squarewavedot/ledcubeelectronics/kiss-battery/v0.2/img-exports/battery-connectors.png

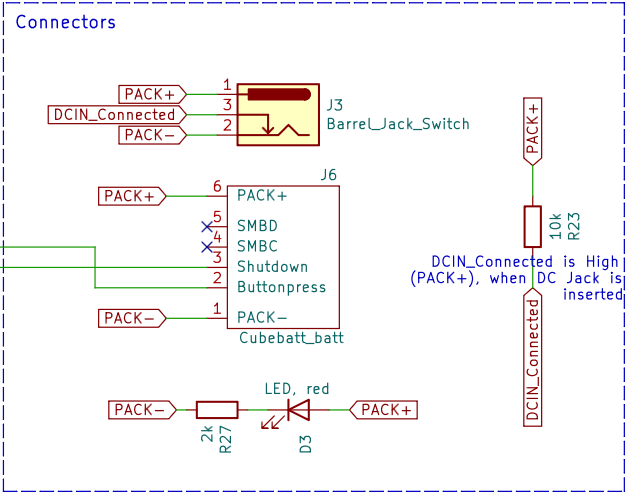
kiss-battery/v0.2/img-exports/battery-connectors.png
