squarewavedot/ledcubeelectronics/kiss-battery/v0.2/img-exports/bms.png

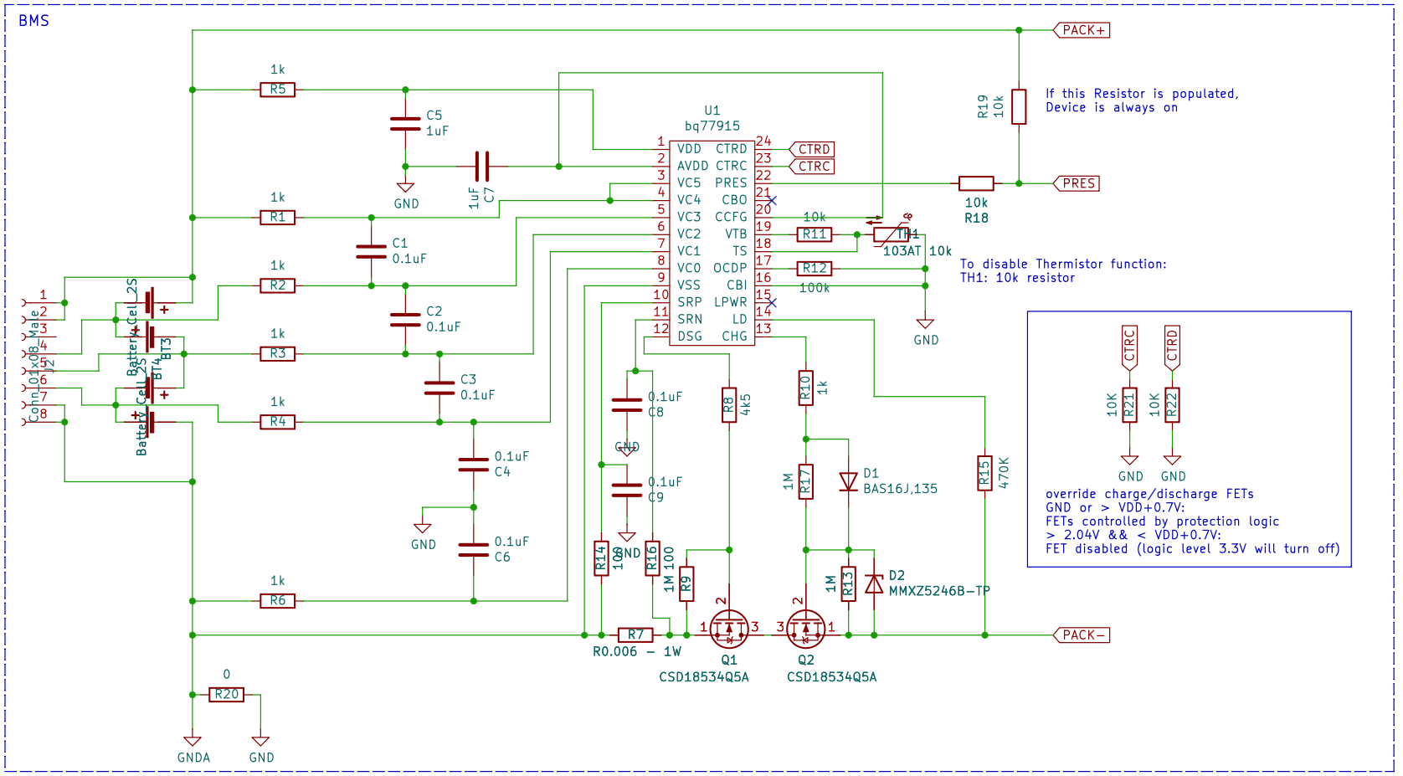
kiss-battery/v0.2/img-exports/bms.png
