squarewavedot/ledcubeelectronics/kiss-battery/v0.2/img-exports/push-button.png

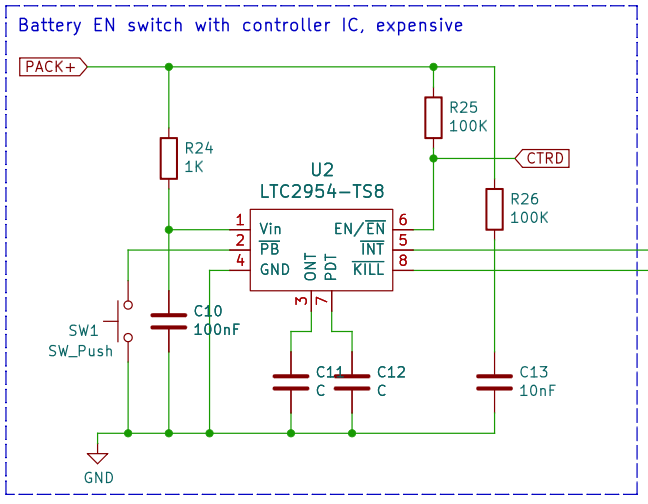
kiss-battery/v0.2/img-exports/push-button.png
