squarewavedot/ledcubeelectronics/kiss-battery/v0.2/bottom/kiss-battery_bottom.pdf

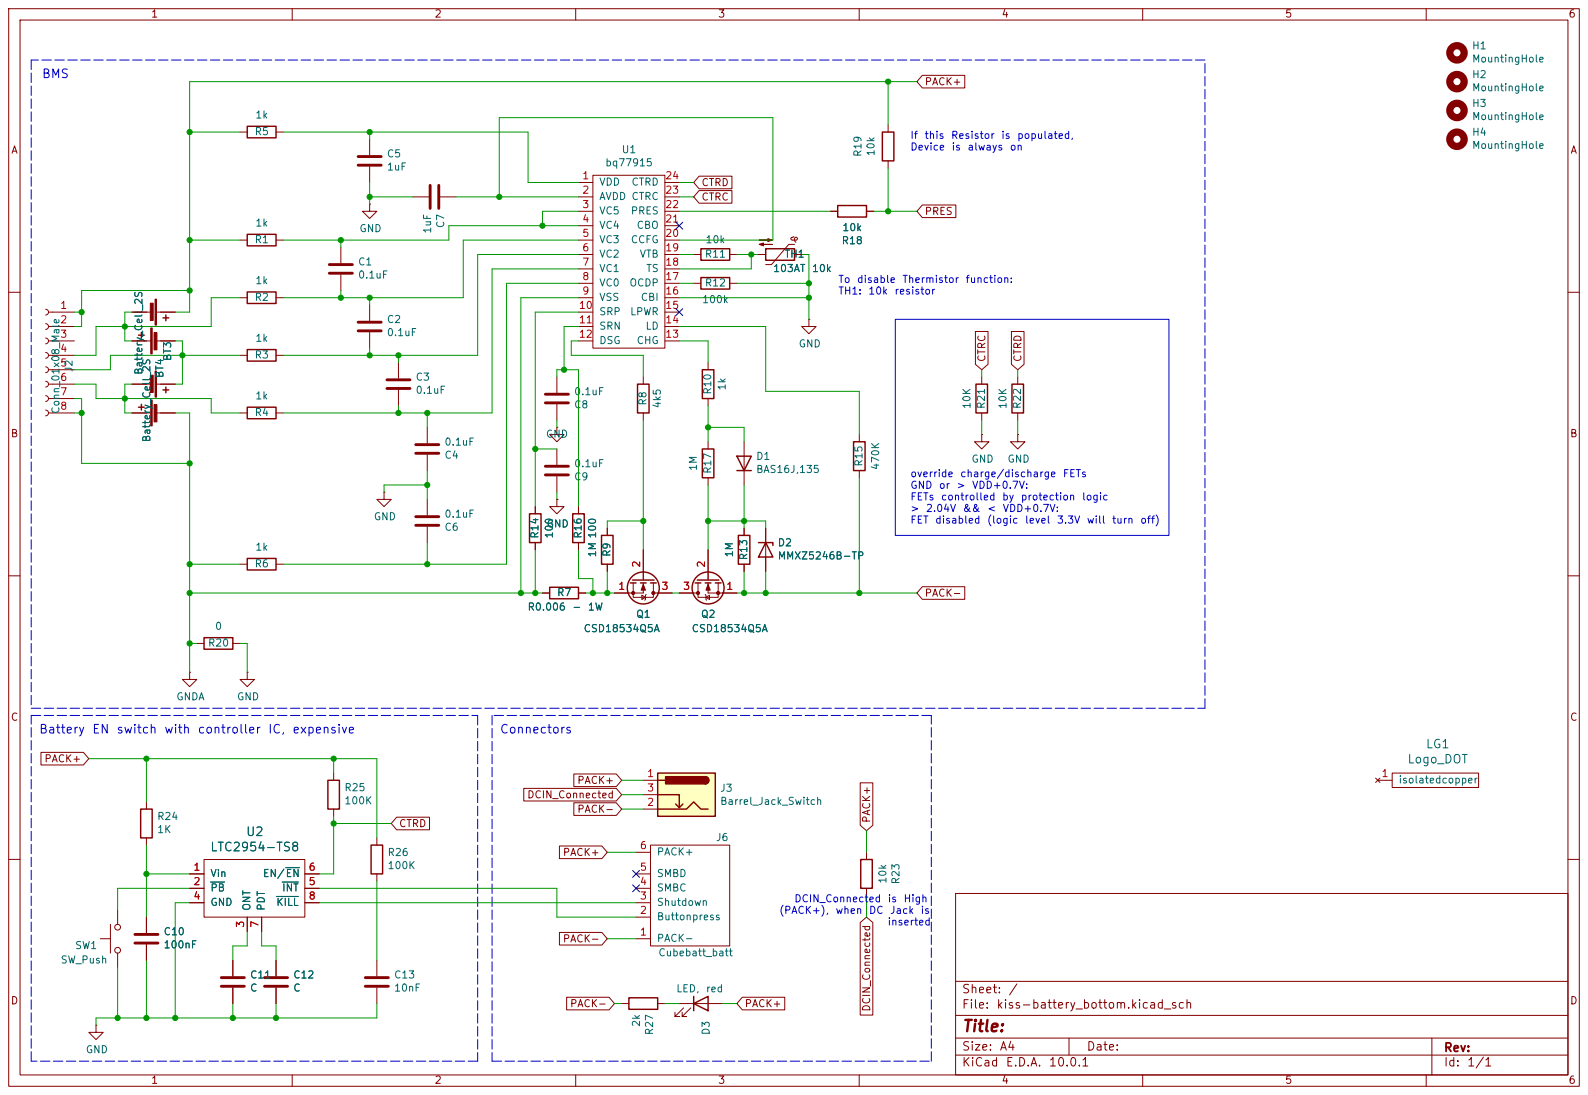
[picture p4: page 1]

If this Resistor is populated, Device is always on

To disable Thermistor function: TH1: 10k resistor

override charge/discharge FETs GND or > VDD+0.7V: FETs controlled by protection logic > 2.04V && < VDD+0.7V: FET disabled (logic level 3.3V will turn off)

Battery EN switch with controller IC, expensive

Size: A4 | Rev:
KiCad E.D.A. 10.0.1 | Id: 1/1
