squarewavedot/ledcubeelectronics/kiss-masterboard/masterboard_v0.2/kiss-masterboard.kicad_pcb

## KiCad design kiss-masterboard/masterboard_v0.2/kiss-masterboard.kicad_pcb (2026-04-28)

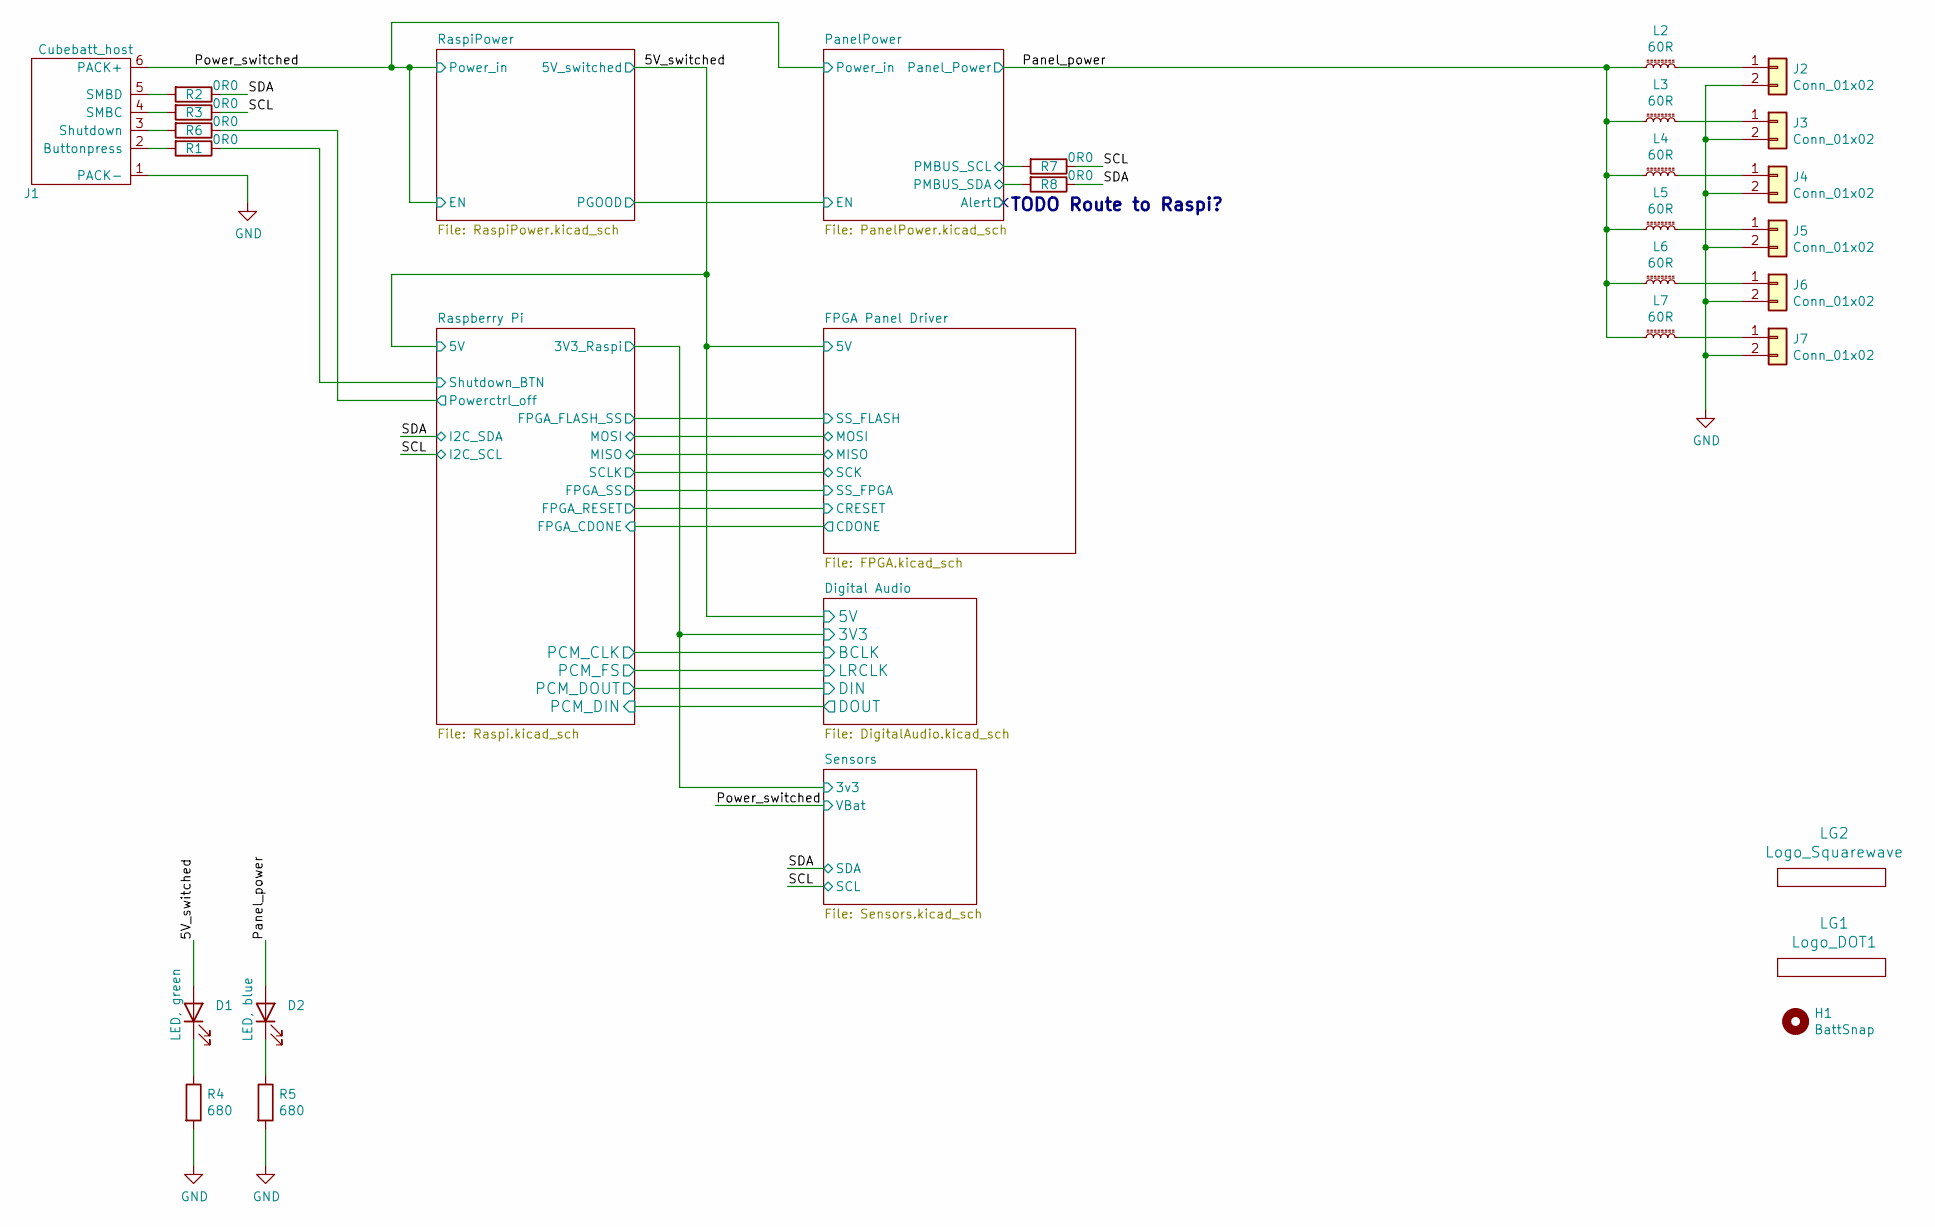
[picture p5: schematic kiss-masterboard.kicad_sch, LEDCube masterboard]

Parts:
D1: LED, green; LED_0603_1608Metric; Part No. LG Q971-KN-1
D2: LED, blue; LED_0603_1608Metric; Part No. LB Q39G-L2N2-35-1
H1: BattSnap; batt_snap
J1: Cubebatt_host; cubebatt_host
J2, J3, J4, J5, J6, J7: Conn_01x02; JST_VH_B2P-VH_1x02_P3.96mm_Vertical
L2, L3, L4, L5, L6, L7: 60R; L_1008_2520Metric; Part No. FBMJ3216HM600-T; Digikey No. 587-1770-1-ND
LG1: Logo_DOT1; Logo_Dot_15mm_Text_Mask
LG2: Logo_Squarewave; Logo_Squarewave_Text_15mm_Silks
R1, R2, R3, R6, R7, R8: 0R0; R_0603_1608Metric; Part No. RC0603JR-07680R
R4, R5: 680; R_0603_1608Metric; Part No. RC0603JR-07680R

Connections:
/5V_switched: D1.2 (A); also elsewhere on the board
/PanelPower/PMBUS_SCL: R7.2; also elsewhere on the board
/PanelPower/PMBUS_SDA: R8.2; also elsewhere on the board
/Panel_power: D2.2 (A), L2.1, L3.1, L4.1, L5.1, L6.1, L7.1; also elsewhere on the board
/Power_switched: J1.6 (PACK+); also elsewhere on the board
/Raspberry Pi/Powerctrl_off: R6.1; also elsewhere on the board
/Raspberry Pi/Shutdown_BTN: R1.1; also elsewhere on the board
/SCL: R3.1, R7.1; also elsewhere on the board
/SDA: R2.1, R8.1; also elsewhere on the board
GND: J1.1 (PACK-), J2.2, J3.2, J4.2, J5.2, J6.2, J7.2, R4.2, R5.2; also elsewhere on the board
unnamed: D1.1 (K), R4.1
unnamed: D2.1 (K), R5.1
unnamed: J1.2 (Buttonpress), R1.2
unnamed: J1.4 (SMBC), R3.2
unnamed: J1.5 (SMBD), R2.2
unnamed: J1.3 (Shutdown), R6.2
unnamed: J2.1, L2.2
unnamed: J3.1, L3.2
unnamed: J4.1, L4.2
unnamed: J5.1, L5.2
unnamed: J6.1, L6.2
unnamed: J7.1, L7.2

Notes on the sheet:
TODO Route to Raspi?

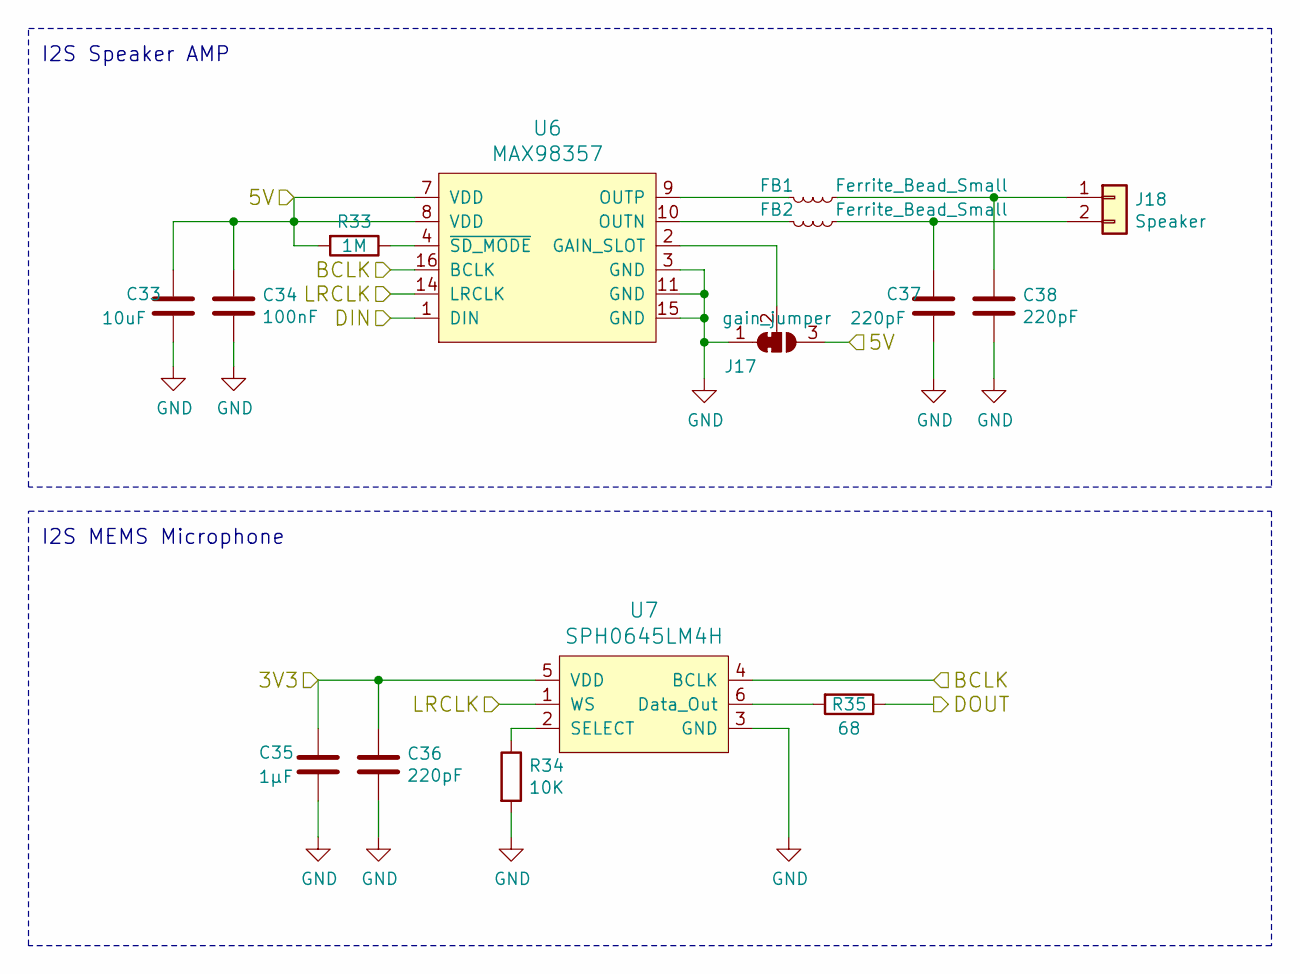
[picture p6: schematic DigitalAudio.kicad_sch]

Parts:
C33: 10uF; C_0603_1608Metric
C34: 100nF; C_0603_1608Metric
C35: 1µF; C_0603_1608Metric
C36, C37, C38: 220pF; C_0603_1608Metric
FB1, FB2: Ferrite_Bead_Small; L_0603_1608Metric
J17: gain_jumper; SolderJumper-3_P1.3mm_Bridged12_Pad1.0x1.5mm_NumberLabels
J18: Speaker; PinHeader_1x02_P2.54mm_Vertical
R33: 1M; R_0603_1608Metric
R34: 10K; R_0603_1608Metric
R35: 68; R_0603_1608Metric
U6: MAX98357; TQFN-16-1EP_3x3mm_P0.5mm_EP1.23x1.23mm
U7: SPH0645LM4H

Connections:
/5V_switched: C33.1, C34.1, J17.3 (B), R33.2, U6.7 (VDD), U6.8 (VDD); also elsewhere on the board
/Digital Audio/BCLK: U6.16 (BCLK), U7.4 (BCLK); also elsewhere on the board
/Digital Audio/DIN: U6.1 (DIN); also elsewhere on the board
/Digital Audio/DOUT: R35.1; also elsewhere on the board
/Digital Audio/LRCLK: U6.14 (LRCLK), U7.1 (WS); also elsewhere on the board
/Raspberry Pi/3v3: C35.1, C36.1, U7.5 (VDD); also elsewhere on the board
GND: C33.2, C34.2, C35.2, C36.2, C37.2, C38.2, J17.1 (A), R34.2, U6.3 (GND), U6.11 (GND), U6.15 (GND), U7.3 (GND); also elsewhere on the board
unnamed: J17.2 (C), U6.2 (GAIN_SLOT)
unnamed: C38.1, FB1.1, J18.1
unnamed: C37.1, FB2.1, J18.2
unnamed: FB2.2, U6.10 (OUTN)
unnamed: FB1.2, U6.9 (OUTP)
unnamed: R33.1, U6.4 (~SD_MODE)
unnamed: R35.2, U7.6 (Data_Out)
unnamed: R34.1, U7.2 (SELECT)

Notes on the sheet:
I2S Speaker AMP
I2S MEMS Microphone

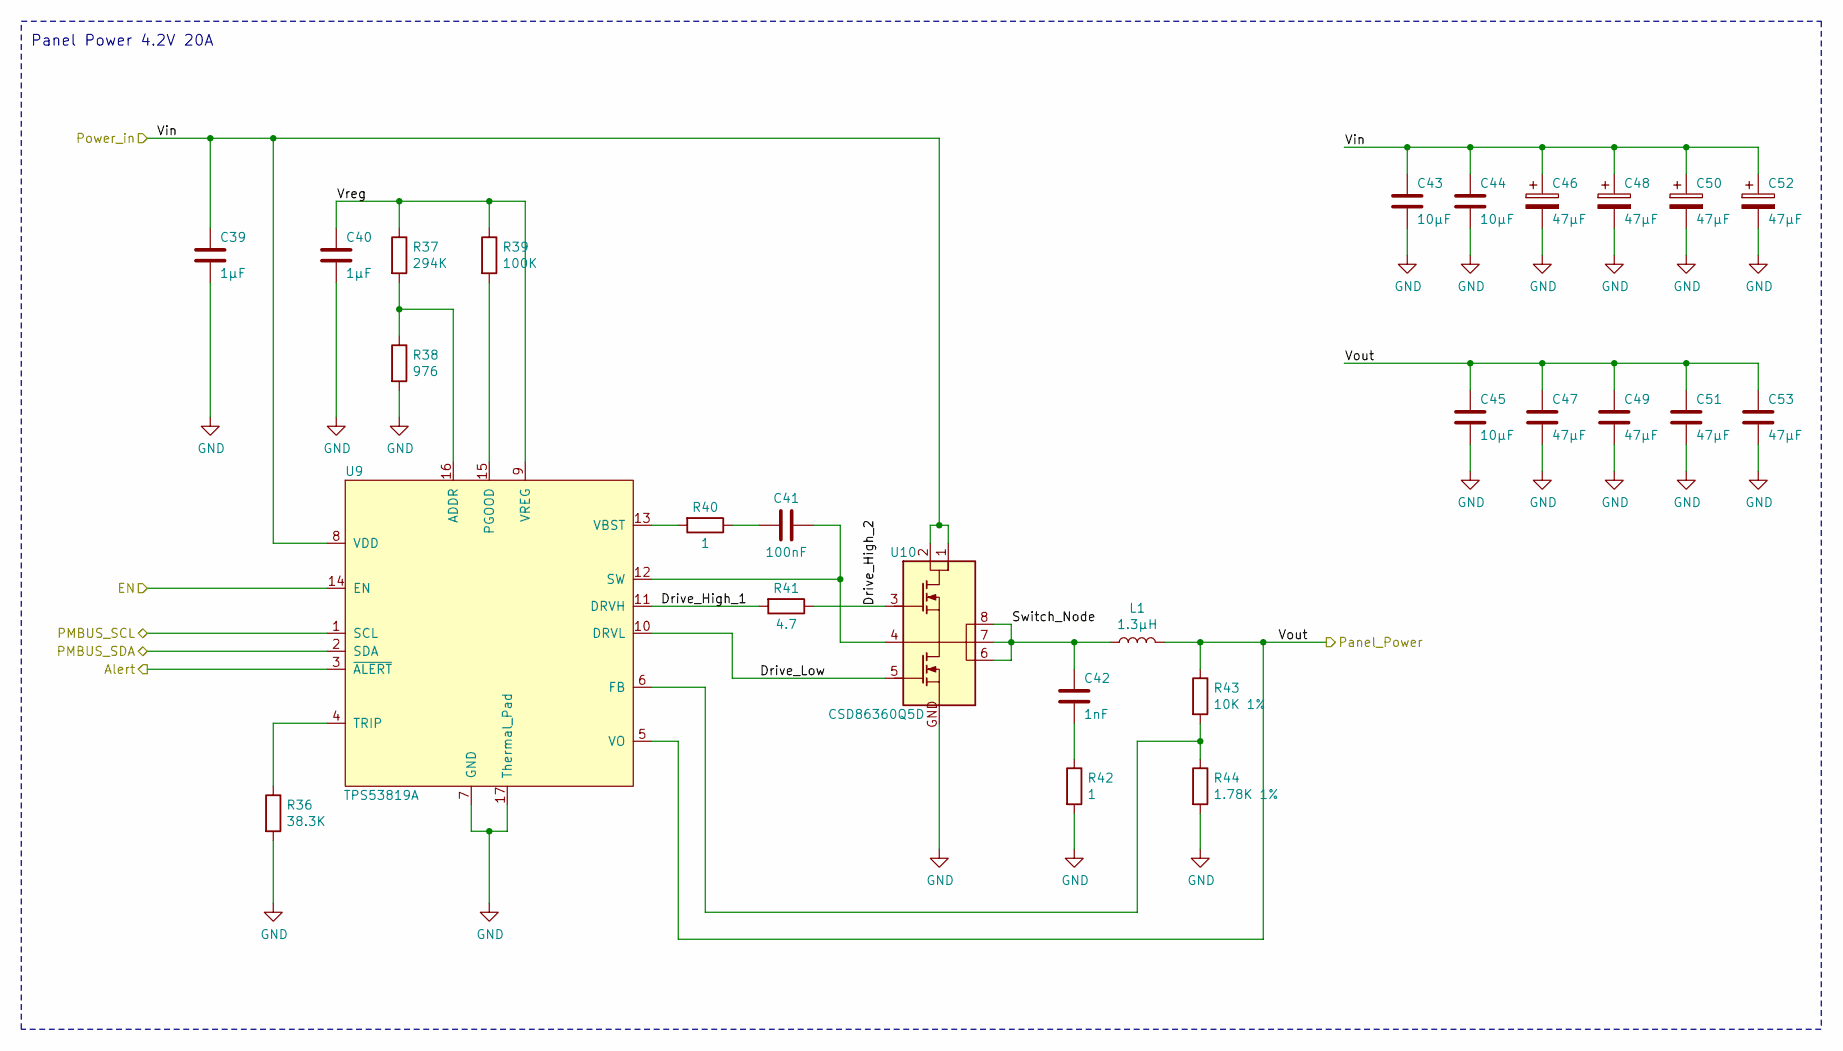
[picture p7: schematic PanelPower.kicad_sch, LEDCube masterboard]

Parts:
C39: 1µF; C_0805_2012Metric; Part No. GMK212B7105KG-T; Digikey No. 587-1438-1-ND
C40: 1µF; C_0603_1608Metric; Part No. GMK212B7105KG-T; Digikey No. 587-1438-1-ND
C41: 100nF; C_0805_2012Metric; Part No. CGA4J2X7R2A104K125AA; Digikey No. 445-5827-1-ND
C42: 1nF; C_0603_1608Metric; Part No. C0603C102J5RACTU; Digikey No. 399-1083-1-ND
C43, C44, C45: 10µF; C_1206_3216Metric; Part No. GRM21BR61E106MA73L; Digikey No. 490-10748-1-ND
C46, C48, C50, C52: 47µF; CP_OSCON_Poly_F12; Part No. 35SVPD47M; Digikey No. PCE5080CT-ND
C47, C49, C51, C53: 47µF; C_1210_3225Metric; Part No. GRM32EC81C476KE15L; Digikey No. 490-10531-1-ND
L1: 1.3µH; Coilcraft_XAL1580; Part No. XAL1580-132MEB; Digikey No. Mouser
R36: 38.3K; R_0603_1608Metric; Part No. RMCF0603FT38K3; Digikey No. RMCF0603FT38K3CT-ND
R37: 294K; R_0402_1005Metric; Part No. CRCW0402294KFKED; Digikey No. 541-294KLCT-ND
R38: 976; R_0402_1005Metric; Part No. CRCW0402976RFKED; Digikey No. 541-976LCT-ND
R39: 100K; R_0603_1608Metric; Part No. RC0603JR-07100K
R40, R42: 1; R_0805_2012Metric; Part No. CRCW08051R00FKEA; Digikey No. 541-1.00CCCT-ND
R41: 4.7; R_0805_2012Metric; Part No. ERJ-6RQF4R7V; Digikey No. P4.7DCT-ND
R43: 10K 1%; R_0603_1608Metric; Part No. RNCP0603FTD10K0; Digikey No. RNCP0603FTD10K0CT-ND
R44: 1.78K 1%; R_0603_1608Metric; Part No. RC0603FR-0717K8L; Digikey No. 311-17.8KHRCT-ND
U9: TPS53819A; VQFN-16-1EP_3x3mm_P0.5mm_EP1.68x1.68mm_ThermalVias; Part No. TPS53819ARGTR; Digikey No. 296-35480-1-ND
U10: CSD86360Q5D; Q5D; Part No. CSD86360Q5D; Digikey No. 296-35026-1-ND

Connections:
/5V_switched: U9.14 (EN); also elsewhere on the board
/PanelPower/Alert: U9.3 (~ALERT)
/PanelPower/Drive_High_1: R41.2, U9.11 (DRVH)
/PanelPower/Drive_High_2: R41.1, U10.3 (TG)
/PanelPower/Drive_Low: U9.10 (DRVL), U10.5 (BG)
/PanelPower/PMBUS_SCL: U9.1 (SCL); also elsewhere on the board
/PanelPower/PMBUS_SDA: U9.2 (SDA); also elsewhere on the board
/PanelPower/Switch_Node: C42.1, L1.1, U10.6 (VSW), U10.7 (VSW), U10.8 (VSW)
/PanelPower/Vreg: C40.1, R37.1, R39.1, U9.9 (VREG)
/Panel_power: C45.1, C47.1, C49.1, C51.1, C53.1, L1.2, R43.1, U9.5 (VO); also elsewhere on the board
/Power_switched: C39.1, C43.1, C44.1, C46.1, C48.1, C50.1, C52.1, U9.8 (VDD), U10.1 (VIN), U10.2 (VIN); also elsewhere on the board
GND: C39.2, C40.2, C43.2, C44.2, C45.2, C46.2, C47.2, C48.2, C49.2, C50.2, C51.2, C52.2, C53.2, R36.2, R38.2, R42.2, R44.2, U9.7 (GND), U9.17 (Thermal_Pad), U10.GND; also elsewhere on the board
unnamed: C41.2, R40.1
unnamed: C42.2, R42.1
unnamed: R37.2, R38.1, U9.16 (ADDR)
unnamed: R43.2, R44.1, U9.6 (FB)
unnamed: R39.2, U9.15 (PGOOD)
unnamed: R36.1, U9.4 (TRIP)
unnamed: R40.2, U9.13 (VBST)
unnamed: C41.1, U9.12 (SW), U10.4 (TGR)

Notes on the sheet:
Panel Power 4.2V 20A

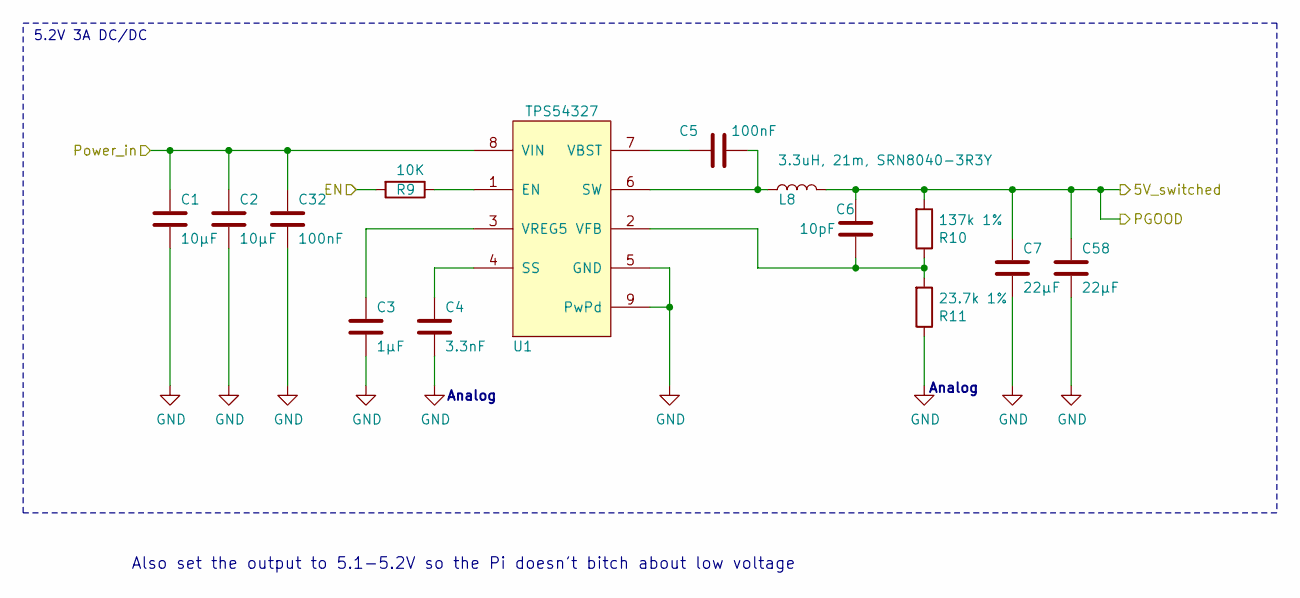
[picture p8: schematic RaspiPower.kicad_sch, LEDCube masterboard]

Parts:
C1, C2: 10µF; C_0805_2012Metric; Part No. GRM21BR61E106MA73L; Digikey No. 490-10748-1-ND
C3: 1µF; C_0603_1608Metric; Part No. GMK212B7105KG-T; Digikey No. 587-1438-1-ND
C4: 3.3nF; C_0603_1608Metric; Part No. GRM188R71H103KA01D
C5: 100nF; C_0603_1608Metric; Part No. GRM188R71H103KA01D
C6: 10pF; C_0603_1608Metric; Part No. GRM188R71H103KA01D
C7, C58: 22µF; C_1210_3225Metric; Part No. LMK325BJ107MM-T; Digikey No. 587-1965-1-ND
C32: 100nF; C_0603_1608Metric; Part No. GMK212B7105KG-T; Digikey No. 587-1438-1-ND
L8: 3.3uH, 21m, SRN8040-3R3Y; Bourns_SRN8040
R9: 10K; R_0603_1608Metric; Part No. RC0603JR-0768K
R10: 137k 1%; R_0603_1608Metric; Part No. RC0603JR-0768K
R11: 23.7k 1%; R_0603_1608Metric; Part No. RC0603JR-0768K
U1: TPS54327; HSOP-8-1EP_3.9x4.9mm_P1.27mm_EP2.41x3.1mm_ThermalVias

Connections:
/5V_switched: C6.2, C7.1, C58.1, L8.2, R10.2; also elsewhere on the board
/Power_switched: C1.1, C2.1, C32.1, R9.2, U1.8 (VIN); also elsewhere on the board
GND: C1.2, C2.2, C3.2, C4.2, C7.2, C32.2, C58.2, R11.1, U1.5 (GND), U1.9 (PwPd); also elsewhere on the board
unnamed: R9.1, U1.1 (EN)
unnamed: C4.1, U1.4 (SS)
unnamed: C5.2, L8.1, U1.6 (SW)
unnamed: C5.1, U1.7 (VBST)
unnamed: C6.1, R10.1, R11.2, U1.2 (VFB)
unnamed: C3.1, U1.3 (VREG5)

Notes on the sheet:
Analog
Also set the output to 5.1-5.2V so the Pi doesn't bitch about low voltage
5.2V 3A DC/DC

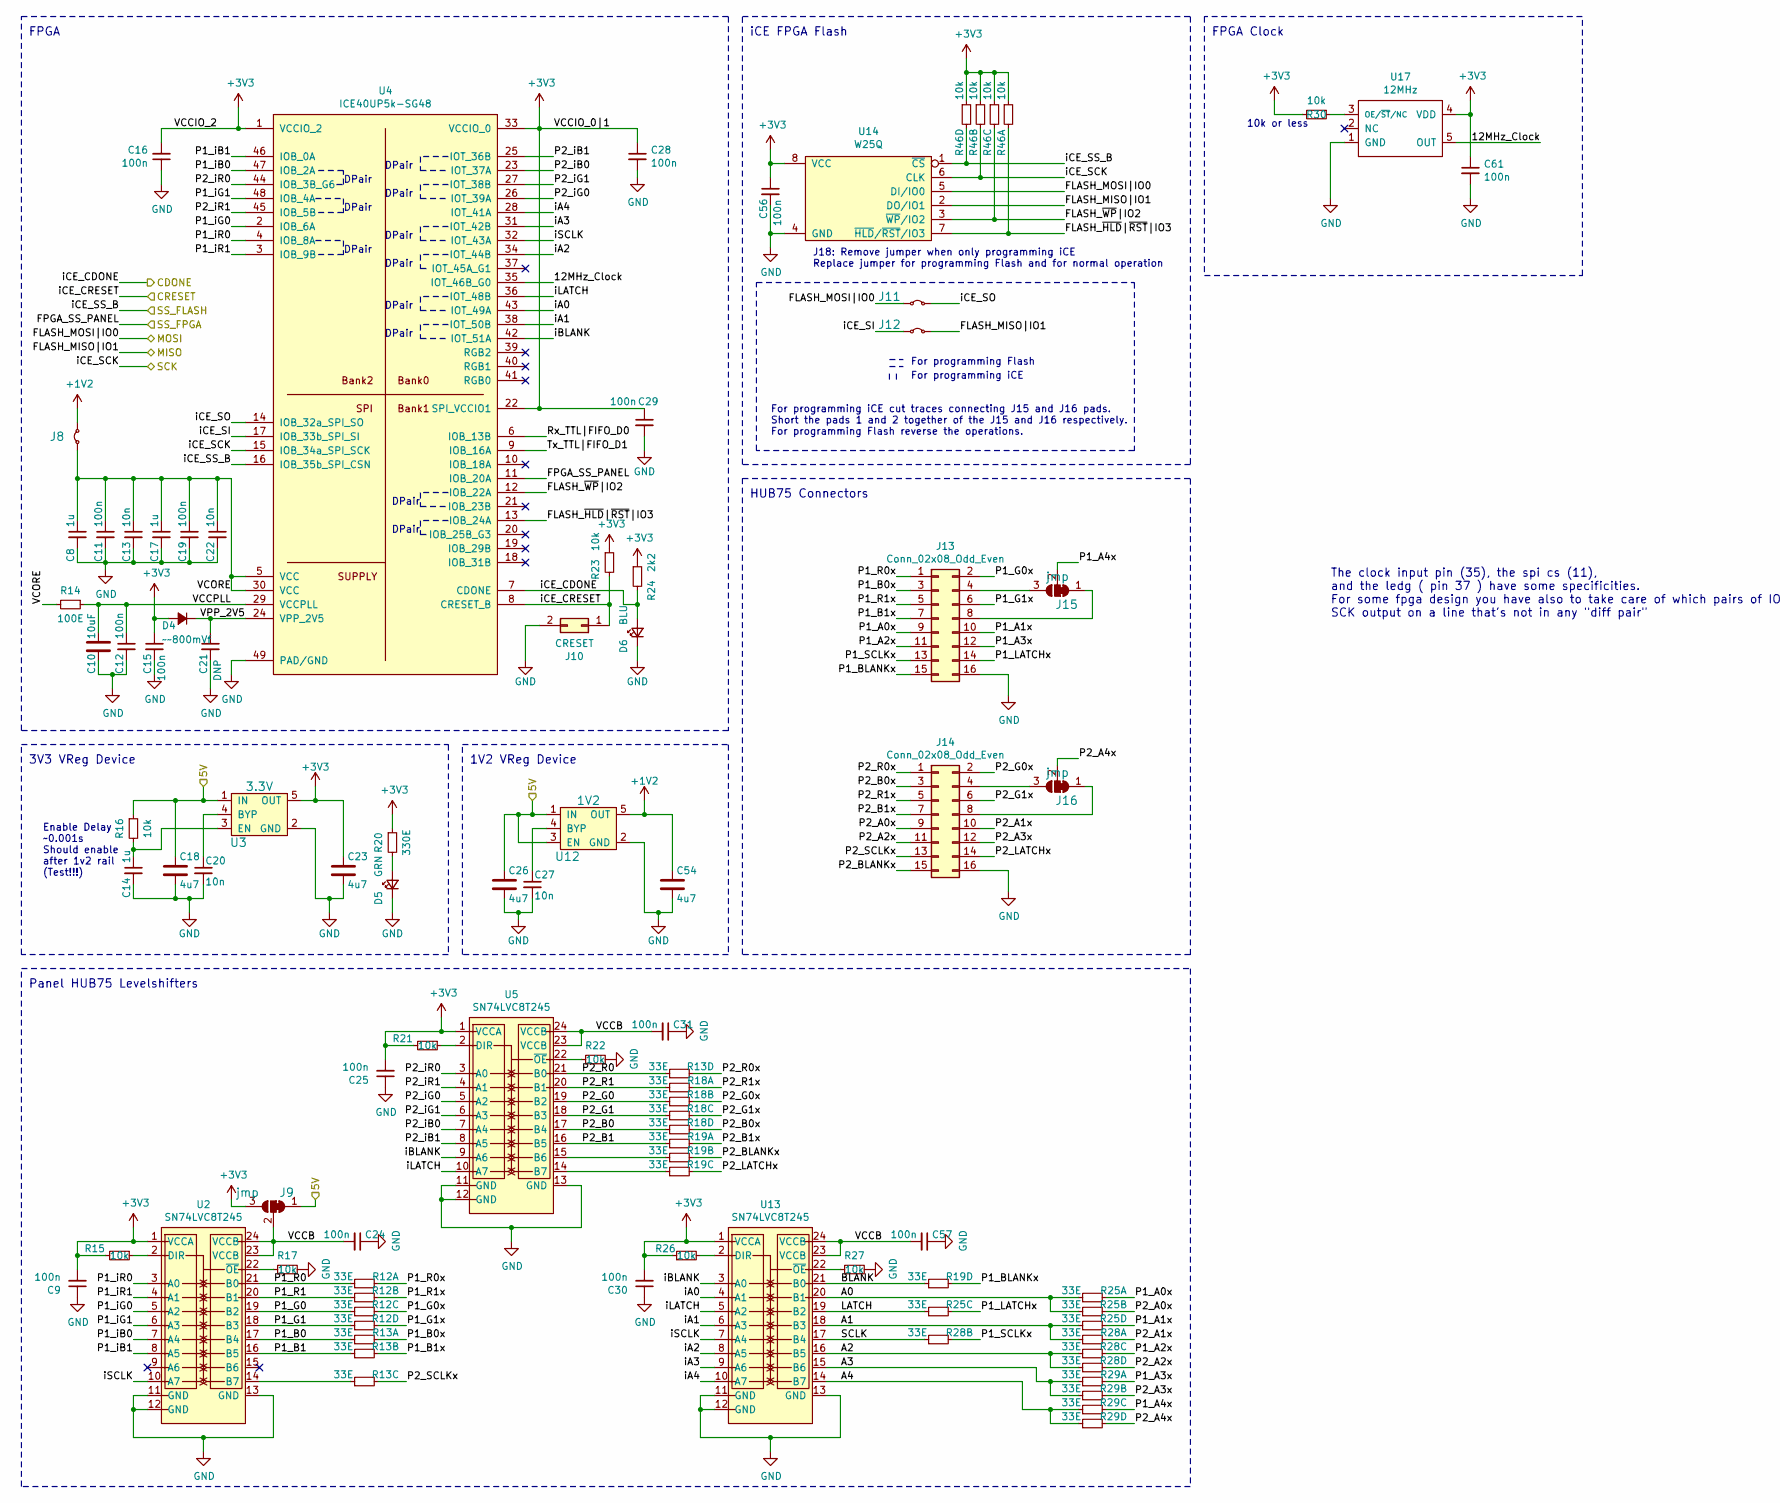
[picture p9: schematic FPGA.kicad_sch, LEDCube masterboard, part in row 1, column 1]

Parts:
C8, C14, C17: 1u; C_0402_1005Metric
C9, C11, C12, C15, C16, C19, C24, C25, C28, C29, C30, C31, C56, C57, C61: 100n; C_0402_1005Metric
C10: 10uF; C_0603_1608Metric
C13, C20, C22, C27: 10n; C_0402_1005Metric
C18, C23, C26, C54: 4u7; C_0603_1608Metric
C21: DNP; C_0402_1005Metric
D4: ~~800mVf; D_SOD-523
D5: GRN; LED_0603_1608Metric
D6: BLU; LED_0603_1608Metric
J8: Jumper; SolderJumper-2_P1.3mm_Bridged_Pad1.0x1.5mm
J9: jmp; J_NCNO_0903_30
J10: CRESET; PinHeader_2x01_P2.54mm_Vertical
J11, J12: Jumper; J_NC_0603_15
J13, J14: Conn_02x08_Odd_Even; PinHeader_2x08_P2.54mm_Vertical_SMD_IDC
J15, J16: jmp; SolderJumper-3_P1.3mm_Bridged12_Pad1.0x1.5mm_NumberLabels
R12, R13, R18, R19, R25, R28, R29: 33E; R_Array_Convex_4x0402
R14: 100E; R_0402_1005Metric
R15, R16, R17, R21, R22, R23, R26, R27, R30: 10k; R_0402_1005Metric
R20: 330E; R_0402_1005Metric
R24: 2k2; R_0402_1005Metric
R46: 10k; R_Array_Convex_4x0402
U2, U5, U13: SN74LVC8T245; TSSOP-24_4.4x7.8mm_P0.65mm
U3: 3.3V; SOT-23-5
U4: ICE40UP5k-SG48; QFN-48-1EP_7x7mm_Pitch0.5mm
U12: 1V2; SOT-23-5
U14: W25Q; SOIC-8_5.3x5.3mm_Pitch1.27mm
U17: 12MHz; SOT-23-5

Connections:
+1V2: C54.1, J8.2 (B), U12.5 (OUT)
+3V3: C9.2, C15.1, C16.2, C23.1, C25.2, C28.1, C29.1, C30.2, C56.1, C61.1, D4.A, J9.3 (B), R15.2, R20.1, R21.2, R23.1, R24.1, R26.1, R30.2, R46.1, R46.3, R46.5, R46.7, U2.1 (VCCA), U3.5 (OUT), U4.1 (VCCIO_2), U4.22 (SPI_VCCIO1), U4.33 (VCCIO_0), U5.1 (VCCA), U13.1 (VCCA), U14.8 (VCC), U17.4 (VDD)
/5V_switched: C18.1, C26.1, J9.1 (A), R16.1, U3.1 (IN), U12.1 (IN), U12.3 (EN); also elsewhere on the board
/FPGA Panel Driver/12MHz_Clock: U4.35 (IOT_46B_G0), U17.5 (OUT)
/FPGA Panel Driver/A0: R25.1, R25.3, U13.20 (B1)
/FPGA Panel Driver/A1: R25.7, R28.1, U13.18 (B3)
/FPGA Panel Driver/A2: R28.5, R28.7, U13.16 (B5)
/FPGA Panel Driver/A3: R29.1, R29.3, U13.15 (B6)
/FPGA Panel Driver/A4: R29.5, R29.7, U13.14 (B7)
/FPGA Panel Driver/BLANK: R19.7, U13.21 (B0)
/FPGA Panel Driver/FLASH_MISO|IO1: J12.2 (B), U14.2 (DO/IO1); also elsewhere on the board
/FPGA Panel Driver/FLASH_MOSI|IO0: J11.1 (A), U14.5 (DI/IO0); also elsewhere on the board
/FPGA Panel Driver/FLASH_~HLD|~RST|IO3: R46.2, U4.13 (IOB_24A), U14.7 (~HLD/~RST/IO3)
/FPGA Panel Driver/FLASH_~WP|IO2: R46.6, U4.12 (IOB_22A), U14.3 (~WP/IO2)
/FPGA Panel Driver/FPGA_SS_PANEL: U4.11 (IOB_20A); also elsewhere on the board
/FPGA Panel Driver/LATCH: R25.5, U13.19 (B2)
/FPGA Panel Driver/P1_A0x: J13.9, R25.2
/FPGA Panel Driver/P1_A1x: J13.10, R25.8
/FPGA Panel Driver/P1_A2x: J13.11, R28.6
/FPGA Panel Driver/P1_A3x: J13.12, R29.2
/FPGA Panel Driver/P1_A4x: J15.2 (C), R29.6
/FPGA Panel Driver/P1_B0: R13.1, U2.17 (B4)
/FPGA Panel Driver/P1_B0x: J13.3, R13.2
/FPGA Panel Driver/P1_B1: R13.3, U2.16 (B5)
/FPGA Panel Driver/P1_B1x: J13.7, R13.4
/FPGA Panel Driver/P1_BLANKx: J13.15, R19.8
/FPGA Panel Driver/P1_G0: R12.5, U2.19 (B2)
/FPGA Panel Driver/P1_G0x: J13.2, R12.6
/FPGA Panel Driver/P1_G1: R12.7, U2.18 (B3)
/FPGA Panel Driver/P1_G1x: J13.6, R12.8
/FPGA Panel Driver/P1_LATCHx: J13.14, R25.6
/FPGA Panel Driver/P1_R0: R12.1, U2.21 (B0)
/FPGA Panel Driver/P1_R0x: J13.1, R12.2
/FPGA Panel Driver/P1_R1: R12.3, U2.20 (B1)
/FPGA Panel Driver/P1_R1x: J13.5, R12.4
/FPGA Panel Driver/P1_SCLKx: J13.13, R28.4
/FPGA Panel Driver/P1_iB0: U2.7 (A4), U4.47 (IOB_2A)
/FPGA Panel Driver/P1_iB1: U2.8 (A5), U4.46 (IOB_0A)
/FPGA Panel Driver/P1_iG0: U2.5 (A2), U4.2 (IOB_6A)
/FPGA Panel Driver/P1_iG1: U2.6 (A3), U4.48 (IOB_4A)
/FPGA Panel Driver/P1_iR0: U2.3 (A0), U4.4 (IOB_8A)
/FPGA Panel Driver/P1_iR1: U2.4 (A1), U4.3 (IOB_9B)
/FPGA Panel Driver/P2_A0x: J14.9, R25.4
/FPGA Panel Driver/P2_A1x: J14.10, R28.2
/FPGA Panel Driver/P2_A2x: J14.11, R28.8
/FPGA Panel Driver/P2_A3x: J14.12, R29.4
/FPGA Panel Driver/P2_A4x: J16.2 (C), R29.8
/FPGA Panel Driver/P2_B0: R18.7, U5.17 (B4)
/FPGA Panel Driver/P2_B0x: J14.3, R18.8
/FPGA Panel Driver/P2_B1: R19.1, U5.16 (B5)
/FPGA Panel Driver/P2_B1x: J14.7, R19.2
/FPGA Panel Driver/P2_BLANKx: J14.15, R19.4
/FPGA Panel Driver/P2_G0: R18.3, U5.19 (B2)
/FPGA Panel Driver/P2_G0x: J14.2, R18.4
/FPGA Panel Driver/P2_G1: R18.5, U5.18 (B3)
/FPGA Panel Driver/P2_G1x: J14.6, R18.6
/FPGA Panel Driver/P2_LATCHx: J14.14, R19.6
/FPGA Panel Driver/P2_R0: R13.7, U5.21 (B0)
/FPGA Panel Driver/P2_R0x: J14.1, R13.8
/FPGA Panel Driver/P2_R1: R18.1, U5.20 (B1)
/FPGA Panel Driver/P2_R1x: J14.5, R18.2
/FPGA Panel Driver/P2_SCLKx: J14.13, R13.6
/FPGA Panel Driver/P2_iB0: U4.23 (IOT_37A), U5.7 (A4)
/FPGA Panel Driver/P2_iB1: U4.25 (IOT_36B), U5.8 (A5)
/FPGA Panel Driver/P2_iG0: U4.26 (IOT_39A), U5.5 (A2)
/FPGA Panel Driver/P2_iG1: U4.27 (IOT_38B), U5.6 (A3)
/FPGA Panel Driver/P2_iR0: U4.44 (IOB_3B_G6), U5.3 (A0)
/FPGA Panel Driver/P2_iR1: U4.45 (IOB_5B), U5.4 (A1)
/FPGA Panel Driver/Rx_TTL|FIFO_D0: U4.6 (IOB_13B)
/FPGA Panel Driver/SCLK: R28.3, U13.17 (B4)
/FPGA Panel Driver/Tx_TTL|FIFO_D1: U4.9 (IOB_16A)
/FPGA Panel Driver/VCCB: C24.2, C31.2, C57.2, J9.2 (C), U2.23 (VCCB), U2.24 (VCCB), U5.23 (VCCB), U5.24 (VCCB), U13.23 (VCCB), U13.24 (VCCB)
/FPGA Panel Driver/VCCPLL: C10.1, C12.1, R14.1, U4.29 (VCCPLL)
/FPGA Panel Driver/VCORE: C8.1, C11.1, C13.1, C17.1, C19.1, C22.1, J8.1 (A), R14.2, U4.5 (VCC), U4.30 (VCC)
/FPGA Panel Driver/VPP_2V5: C21.1, D4.C, U4.24 (VPP_2V5)
/FPGA Panel Driver/iA0: U4.43 (IOT_49A), U13.4 (A1)
/FPGA Panel Driver/iA1: U4.38 (IOT_50B), U13.6 (A3)
/FPGA Panel Driver/iA2: U4.34 (IOT_44B), U13.8 (A5)
/FPGA Panel Driver/iA3: U4.31 (IOT_42B), U13.9 (A6)
/FPGA Panel Driver/iA4: U4.28 (IOT_41A), U13.10 (A7)
/FPGA Panel Driver/iBLANK: U4.42 (IOT_51A), U5.9 (A6), U13.3 (A0)
/FPGA Panel Driver/iCE_CDONE: D6.2 (A), R24.2, U4.7 (CDONE); also elsewhere on the board
/FPGA Panel Driver/iCE_CRESET: J10.1, R23.2, U4.8 (CRESET_B); also elsewhere on the board
/FPGA Panel Driver/iCE_SCK: R46.4, U4.15 (IOB_34a_SPI_SCK), U14.6 (CLK); also elsewhere on the board
/FPGA Panel Driver/iCE_SI: J12.1 (A), U4.17 (IOB_33b_SPI_SI)
/FPGA Panel Driver/iCE_SO: J11.2 (B), U4.14 (IOB_32a_SPI_SO)
/FPGA Panel Driver/iCE_SS_B: R46.8, U4.16 (IOB_35b_SPI_CSN), U14.1 (~CS); also elsewhere on the board
/FPGA Panel Driver/iLATCH: U4.36 (IOT_48B), U5.10 (A7), U13.5 (A2)
/FPGA Panel Driver/iSCLK: U2.10 (A7), U4.32 (IOT_43A), U13.7 (A4)
GND: C8.2, C9.1, C10.2, C11.2, C12.2, C13.2, C14.2, C15.2, C16.1, C17.2, C18.2, C19.2, C20.2, C21.2, C22.2, C23.2, C24.1, C25.1, C26.2, C27.2, C28.2, C29.2, C30.1, C31.1, C54.2, C56.2, C57.1, C61.2, D5.1 (K), D6.1 (K), J10.2, J13.16, J14.16, R17.2, R22.2, R27.2, U2.11 (GND), U2.12 (GND), U2.13 (GND), U3.2 (GND), U4.49 (PAD/GND), U5.11 (GND), U5.12 (GND), U5.13 (GND), U12.2 (GND), U13.11 (GND), U13.12 (GND), U13.13 (GND), U14.4 (GND), U17.1 (GND); also elsewhere on the board
unnamed: D5.2 (A), R20.2
unnamed: J13.4, J15.3 (B)
unnamed: J13.8, J15.1 (A)
unnamed: J14.4, J16.3 (B)
unnamed: J14.8, J16.1 (A)
unnamed: R13.5, U2.14 (B7)
unnamed: R15.1, U2.2 (DIR)
unnamed: R17.1, U2.22 (~OE)
unnamed: C20.1, U3.4 (BYP)
unnamed: C14.1, R16.2, U3.3 (EN)
unnamed: R19.3, U5.15 (B6)
unnamed: R19.5, U5.14 (B7)
unnamed: R21.1, U5.2 (DIR)
unnamed: R22.1, U5.22 (~OE)
unnamed: C27.1, U12.4 (BYP)
unnamed: R26.2, U13.2 (DIR)
unnamed: R27.1, U13.22 (~OE)
unnamed: R30.1, U17.3 (OE/~ST/NC)

Notes on the sheet:
DPair
Panel HUB75 Levelshifters
FPGA
Enable Delay ~0.001s Should enable after 1v2 rail (Test!!!)
For programming iCE cut traces connecting J15 and J16 pads. Short the pads 1 and 2 together of the J15 and J16 respectively. For programming Flash reverse the operations.
1V2 VReg Device
For programming Flash
J18: Remove jumper when only programming iCE Replace jumper for programming Flash and for normal operation
DPair
The clock input pin (35), the spi cs (11), and the ledg ( pin 37 ) have some specificities. For some fpga design you have also to take care of which pairs of IO end up on a given IO site because of shared control lines to the IOB but for the hub75 driver I specifically made sure that all IOs use th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
iCE FPGA Flash
3V3 VReg Device
10k or less
HUB75 Connectors
For programming iCE
FPGA Clock

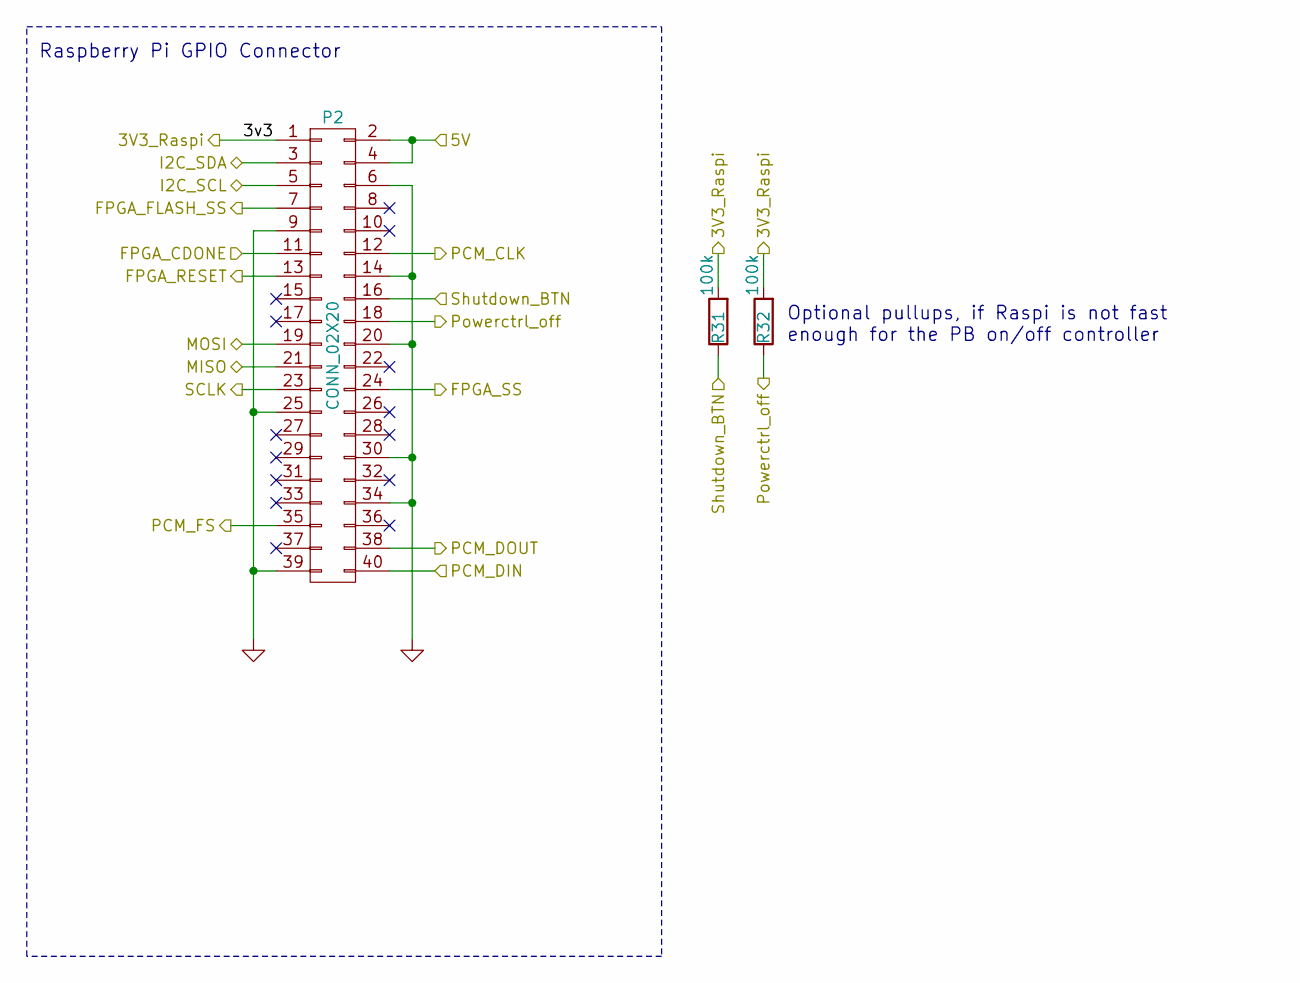
[picture p10: schematic Raspi.kicad_sch, LEDCube masterboard]

Parts:
P2: CONN_02X20; raspberrypi_connector_mounting
R31, R32: 100k; R_0603_1608Metric; Part No. RC0603JR-07680R

Connections:
/5V_switched: P2.2, P2.4; also elsewhere on the board
/Digital Audio/BCLK: P2.12; also elsewhere on the board
/Digital Audio/DIN: P2.38; also elsewhere on the board
/Digital Audio/DOUT: P2.40; also elsewhere on the board
/Digital Audio/LRCLK: P2.35; also elsewhere on the board
/FPGA Panel Driver/FLASH_MISO|IO1: P2.21; also elsewhere on the board
/FPGA Panel Driver/FLASH_MOSI|IO0: P2.19; also elsewhere on the board
/FPGA Panel Driver/FPGA_SS_PANEL: P2.24; also elsewhere on the board
/FPGA Panel Driver/iCE_CDONE: P2.11; also elsewhere on the board
/FPGA Panel Driver/iCE_CRESET: P2.13; also elsewhere on the board
/FPGA Panel Driver/iCE_SCK: P2.23; also elsewhere on the board
/FPGA Panel Driver/iCE_SS_B: P2.7; also elsewhere on the board
/Raspberry Pi/3v3: P2.1, R31.2, R32.2; also elsewhere on the board
/Raspberry Pi/Powerctrl_off: P2.18, R32.1; also elsewhere on the board
/Raspberry Pi/Shutdown_BTN: P2.16, R31.1; also elsewhere on the board
/SCL: P2.5; also elsewhere on the board
/SDA: P2.3; also elsewhere on the board
GND: P2.6, P2.9, P2.14, P2.20, P2.25, P2.30, P2.34, P2.39; also elsewhere on the board

Notes on the sheet:
Raspberry Pi GPIO Connector
Optional pullups, if Raspi is not fast enough for the PB on/off controller

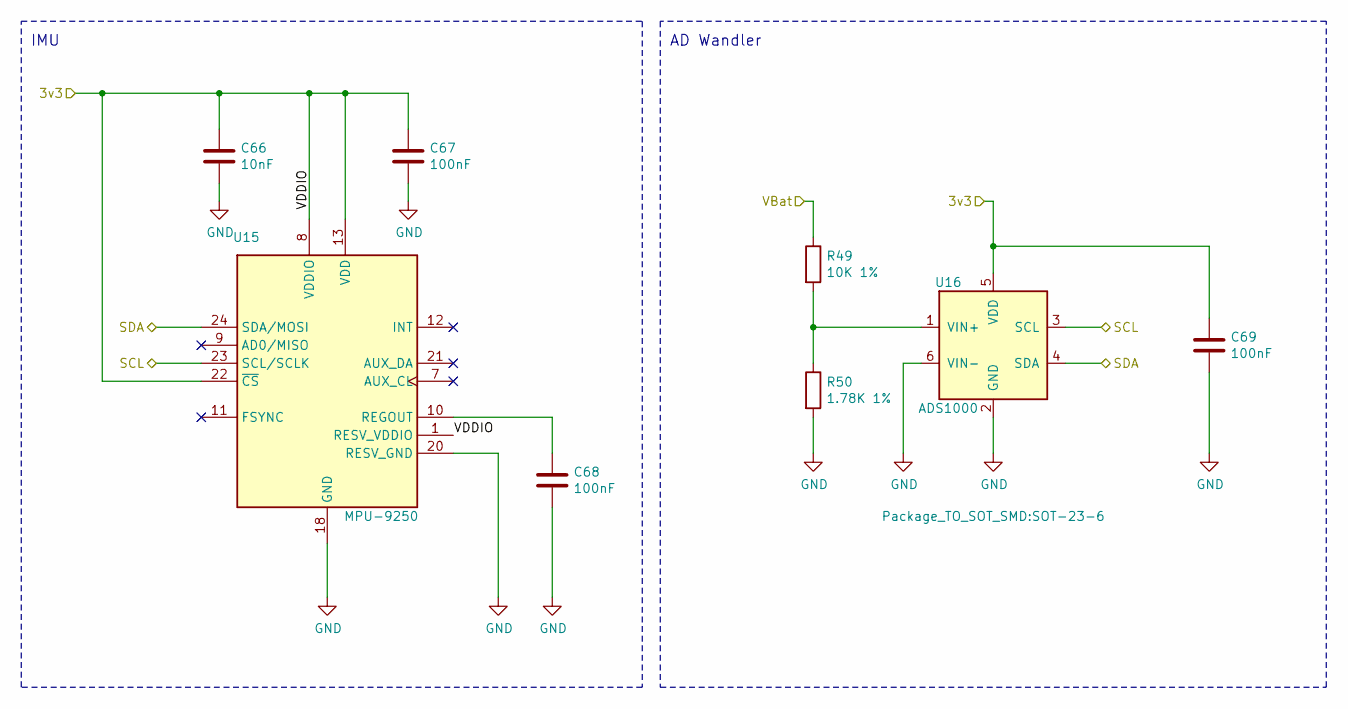
[picture p11: schematic Sensors.kicad_sch, LEDCube masterboard]

Parts:
C66: 10nF; C_0603_1608Metric; Part No. GRM188R71H103KA01D
C67, C68, C69: 100nF; C_0603_1608Metric; Part No. GRM188R71C104KA01D
R49: 10K 1%; R_0603_1608Metric; Part No. RNCP0603FTD10K0; Digikey No. RNCP0603FTD10K0CT-ND
R50: 1.78K 1%; R_0603_1608Metric; Part No. RC0603FR-0717K8L; Digikey No. 311-17.8KHRCT-ND
U15: MPU-9250; InvenSense_QFN-24_3x3mm_P0.4mm; Part No. MPU-9250; Digikey No. 1428-1019-1-ND
U16: ADS1000; SOT-23-6; Part No. ADS1000A0IDBVR; Digikey No. 296-38847-1-ND

Connections:
/Power_switched: R49.1; also elsewhere on the board
/Raspberry Pi/3v3: C66.1, C67.1, C69.1, U15.1 (RESV_VDDIO), U15.8 (VDDIO), U15.13 (VDD), U15.22 (~CS), U16.5 (VDD); also elsewhere on the board
/SCL: U15.23 (SCL/SCLK), U16.3 (SCL); also elsewhere on the board
/SDA: U15.24 (SDA/MOSI), U16.4 (SDA); also elsewhere on the board
GND: C66.2, C67.2, C68.2, C69.2, R50.2, U15.18 (GND), U15.20 (RESV_GND), U16.2 (GND), U16.6 (VIN-); also elsewhere on the board
unnamed: C68.1, U15.10 (REGOUT)
unnamed: R49.2, R50.1, U16.1 (VIN+)

Notes on the sheet:
AD Wandler
IMU
