squarewavedot/ledcubeelectronics/kiss-masterboard/masterboard_v0.2/kiss-masterboard.kicad_pcb

## KiCad design kiss-masterboard/masterboard_v0.2/kiss-masterboard.kicad_pcb (continued)

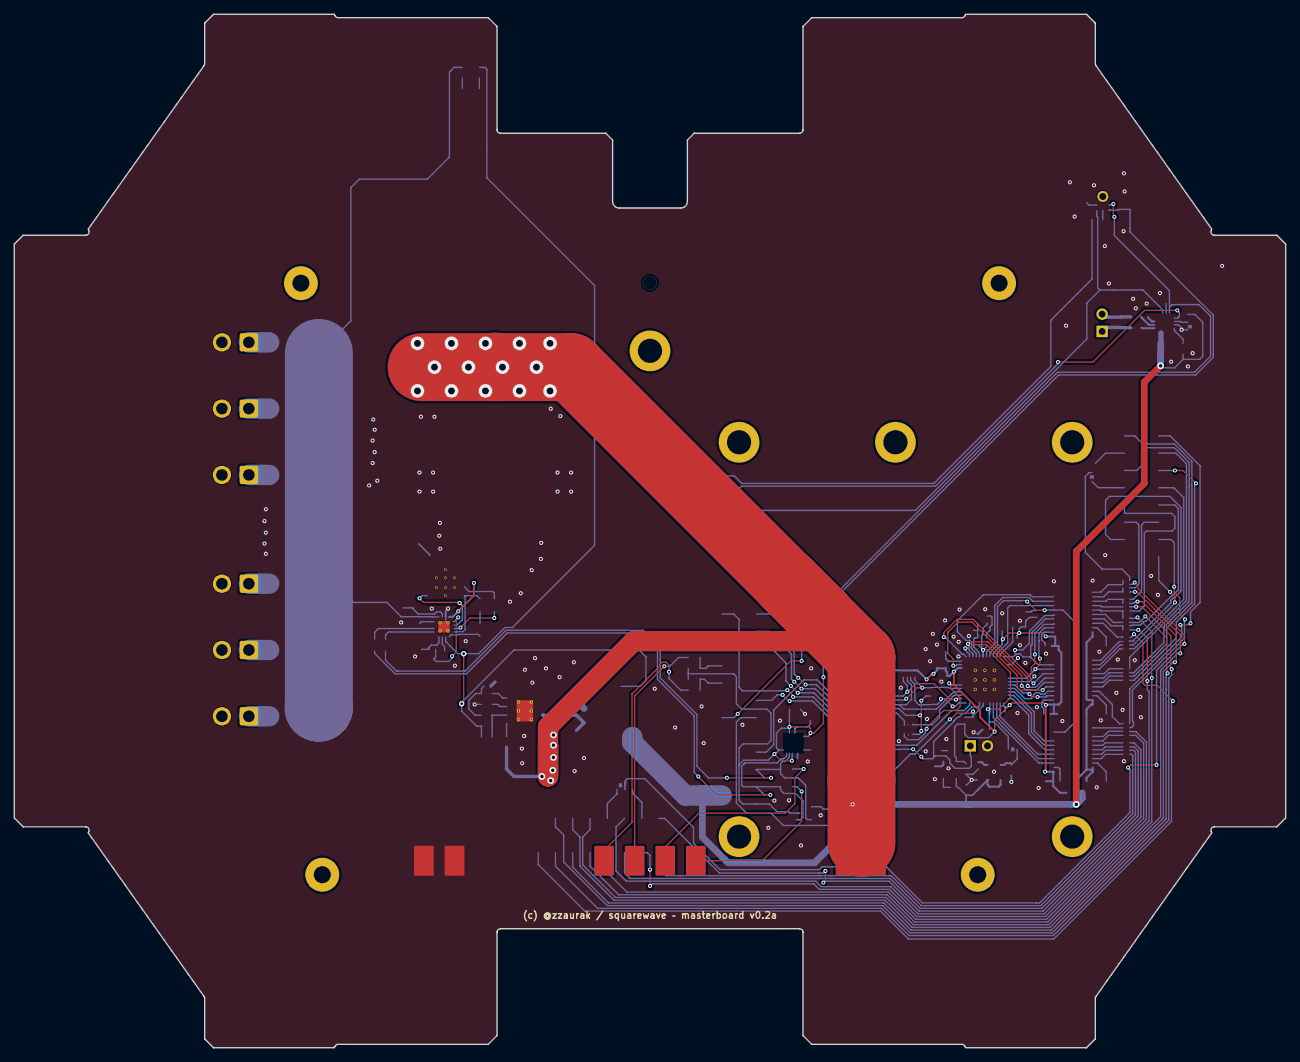
[picture p12: board kiss-masterboard.kicad_pcb from above]

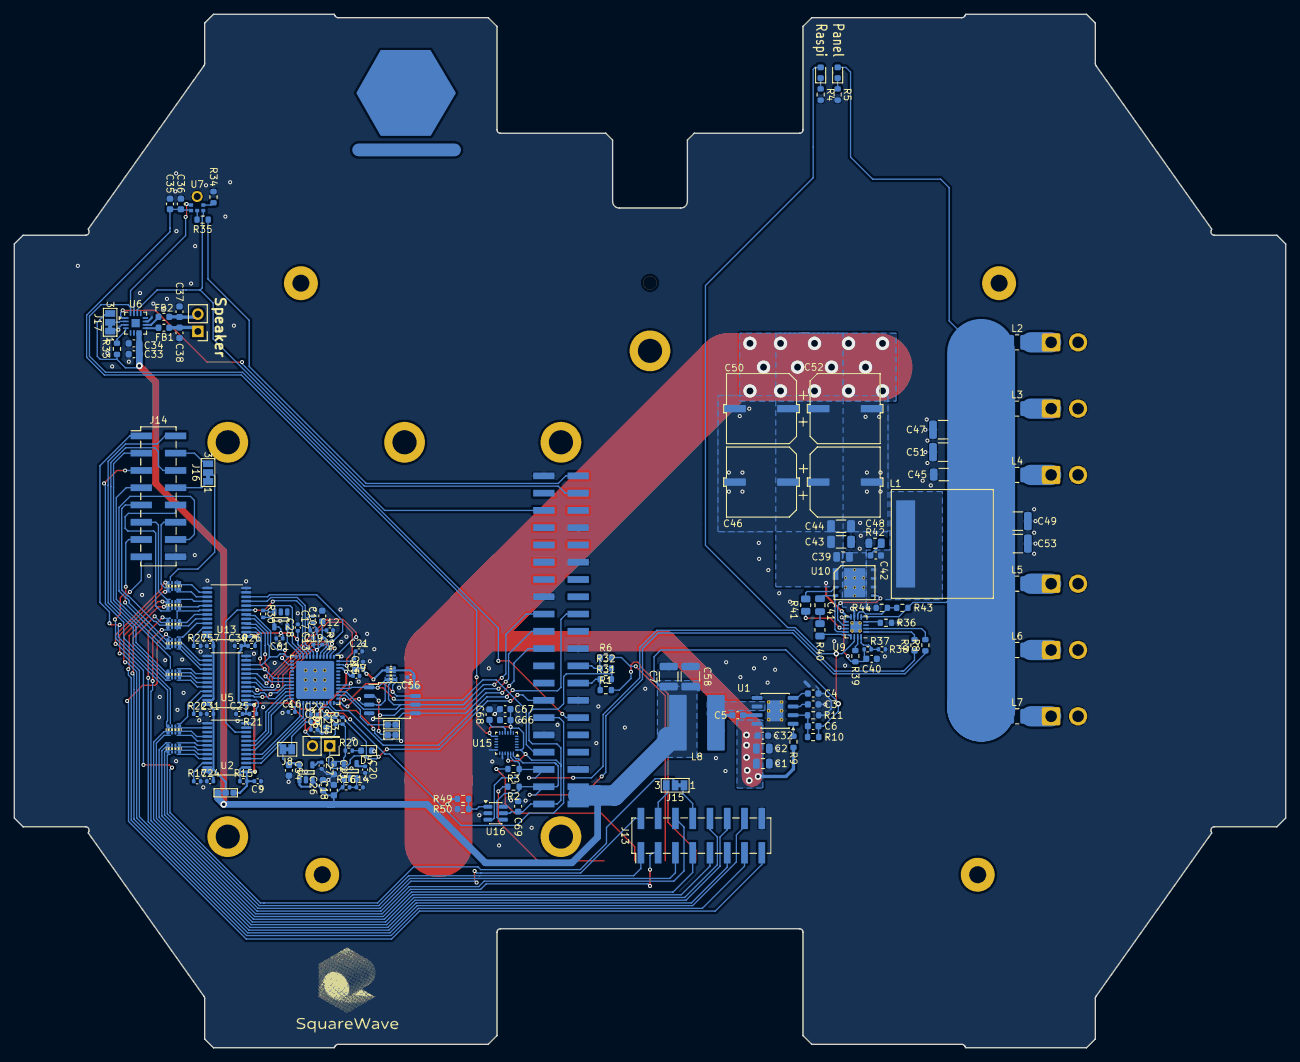
[picture p13: board kiss-masterboard.kicad_pcb from below]

Board: 2 copper layers, 187.0 x 152.0 mm, 161 parts (160 on the bottom side), 160 nets.
