squarewavedot/ledcubeelectronics/kiss-battery/v0.2/bottom/kiss-battery_bottom.kicad_pcb

## KiCad design kiss-battery/v0.2/bottom/kiss-battery_bottom.kicad_pcb (2020-10-03)

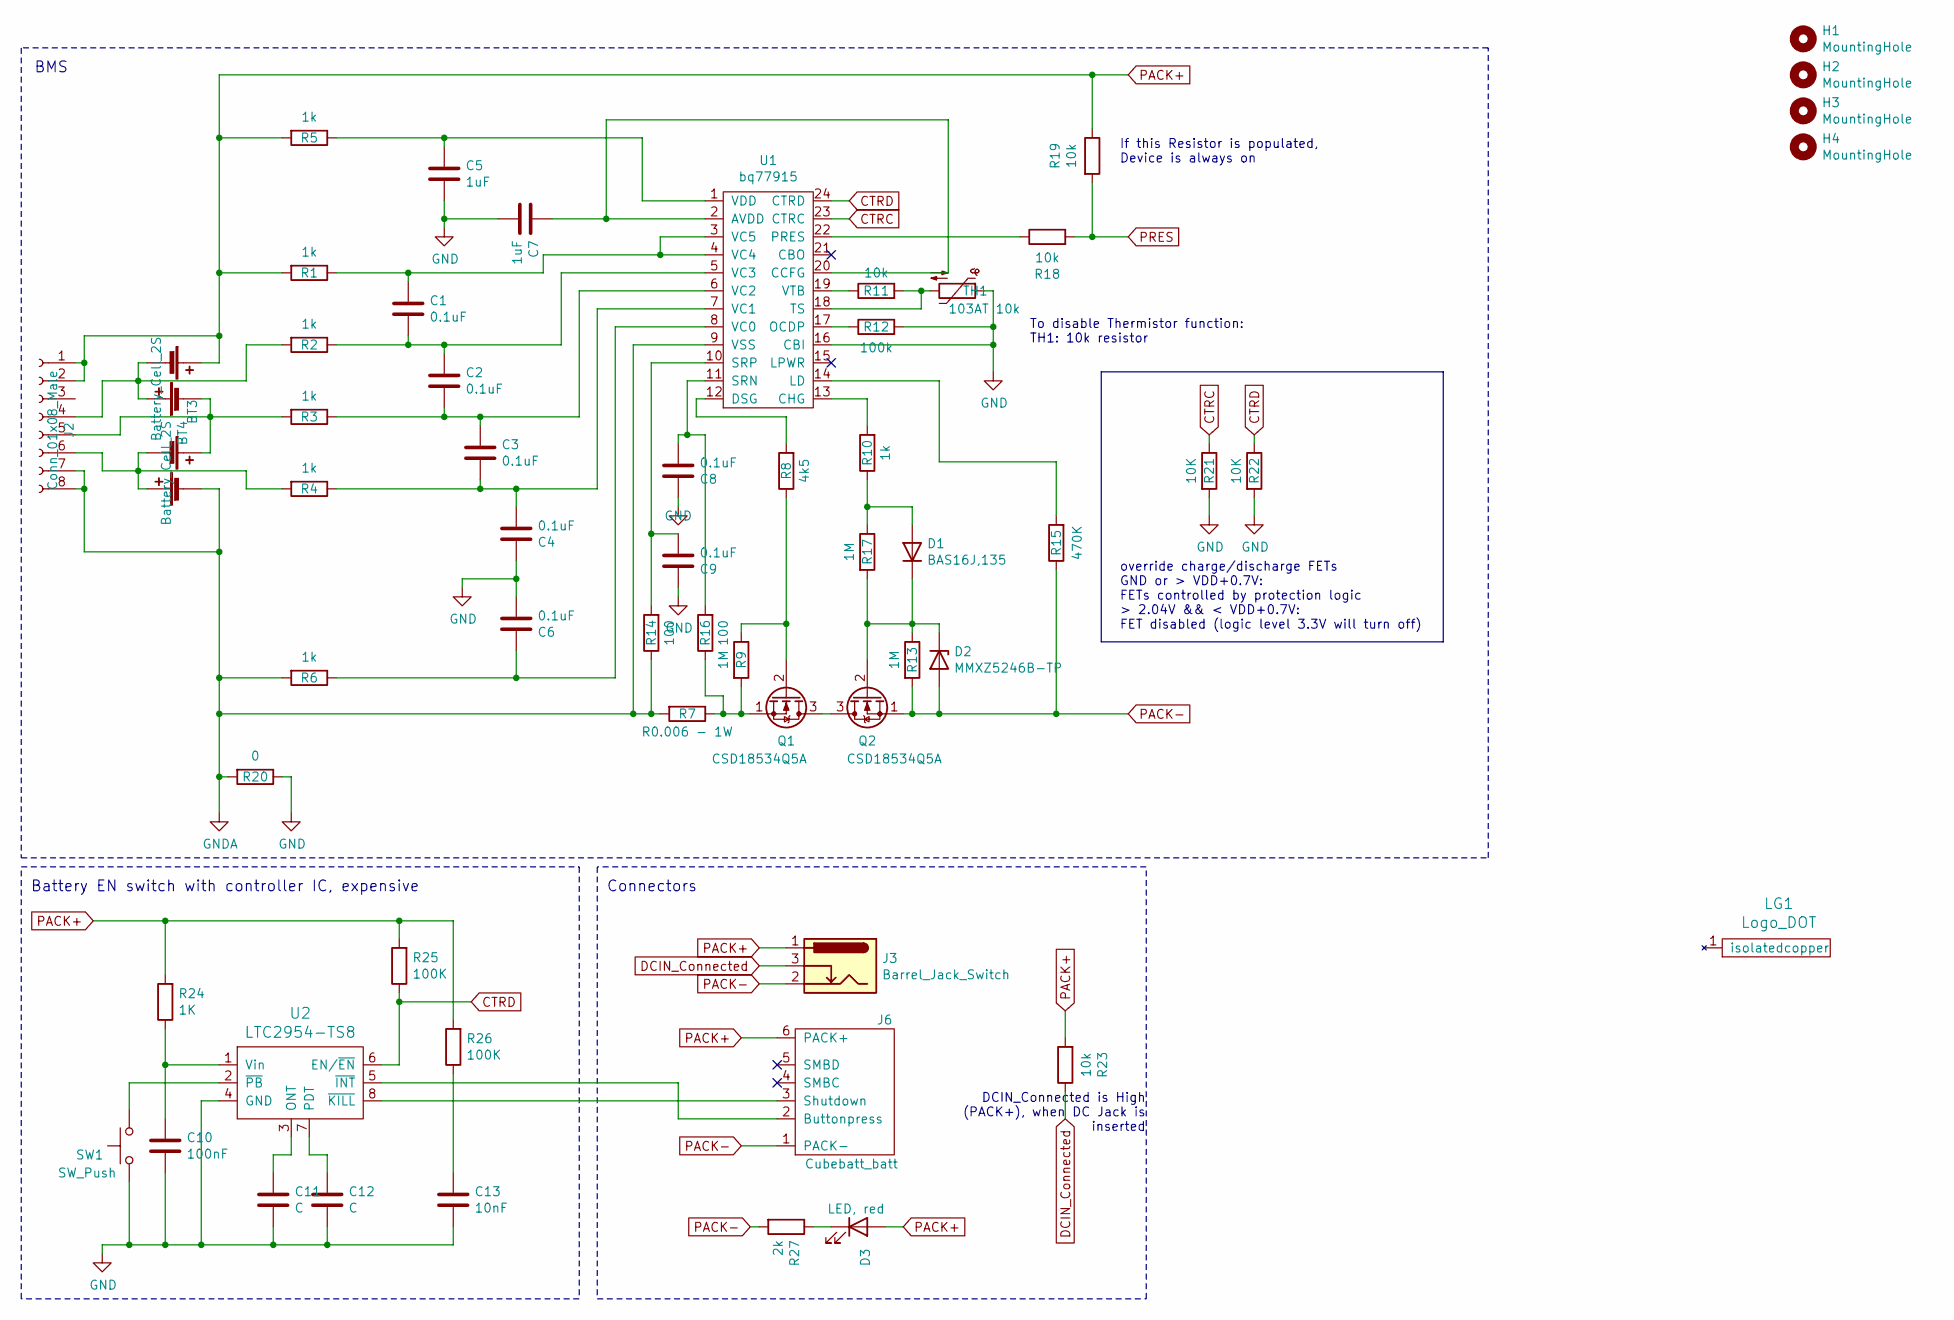
[picture p14: schematic kiss-battery_bottom.kicad_sch]

Parts:
BT3, BT4: Battery_Cell_2S; Battholder_18650x2_BLM
C1, C2, C3, C4, C6, C8, C9: 0.1uF; C_0603_1608Metric
C5, C7: 1uF; C_0603_1608Metric
C10: 100nF; C_0603_1608Metric
C11, C12: C; C_0603_1608Metric
C13: 10nF; C_0603_1608Metric
D1: BAS16J,135; D_SOD-323F
D2: MMXZ5246B-TP; D_SOD-323
D3: LED, red; LED_0603_1608Metric; Part No. LB Q39G-L2N2-35-1
H1, H2, H3, H4: MountingHole; MountingHole_3.2mm_M3_ISO14580
J2: Conn_01x08_Male; PinSocket_1x08_P2.54mm_Vertical_SMD_Pin1Left
J3: Barrel_Jack_Switch; DC_Jack_PJ-036BH-SMT
J6: Cubebatt_batt; cube_battery_connector_battside
LG1: Logo_DOT; Logo_Squarewave_Text_15mm_Silks
Q1, Q2: CSD18534Q5A; VSONP-8-1EP_5x6_P1.27mm
R1, R2, R3, R4, R5, R6, R10: 1k; R_0805_2012Metric
R7: R0.006 - 1W; R_2010_5025Metric
R8: 4k5; R_0603_1608Metric
R9, R13, R17: 1M; R_0603_1608Metric
R11, R18, R19, R23: 10k; R_0603_1608Metric
R12: 100k; R_0603_1608Metric
R14, R16: 100; R_0603_1608Metric
R15: 470K; R_0603_1608Metric
R20: 0; R_0805_2012Metric
R21, R22: 10K; R_0603_1608Metric
R24: 1K; R_0603_1608Metric
R25, R26: 100K; R_0603_1608Metric
R27: 2k; R_0603_1608Metric_Pad1.05x0.95mm_HandSolder; Part No. RC0603JR-07680R
SW1: SW_Push; Tact_Switch_Side_Boss_B3U-3000P-B
TH1: 103AT 10k; R_0603_1608Metric
U1: bq77915; TSSOP-24_4.4x7.8mm_P0.65mm
U2: LTC2954-TS8; TSOT-23-8

Connections:
CTRC: R21.1, U1.23 (CTRC)
CTRD: R22.1, R25.1, U1.24 (CTRD), U2.6 (EN/~EN)
DCIN_Connected: J3.3, R23.1
GND: C4.1, C5.2, C6.2, C7.2, C8.1, C9.1, C10.1, C11.2, C12.2, C13.2, R12.2, R20.1, R21.2, R22.2, SW1.2, TH1.1, U1.16 (CBI), U2.4 (GND)
GNDA: BT3.4 (2N), J2.7, J2.8, R6.2, R7.2, R14.1, R20.2, U1.9 (VSS)
unnamed: BT3.1 (1P), BT4.4 (2N), J2.5, R3.2
unnamed: BT3.2 (1N), BT3.3 (2P), J2.6, R4.2
unnamed: BT4.2 (1N), BT4.3 (2P), J2.4, R2.2
unnamed: C1.1, R1.1, U1.3 (VC5), U1.4 (VC4)
unnamed: C1.2, C2.1, R2.1, U1.5 (VC3)
unnamed: C2.2, C3.1, R3.1, U1.6 (VC2)
unnamed: C3.2, C4.2, R4.1, U1.7 (VC1)
unnamed: C5.1, R5.1, U1.1 (VDD)
unnamed: C6.1, R6.1, U1.8 (VC0)
unnamed: C7.1, U1.2 (AVDD), U1.20 (CCFG)
unnamed: C8.2, R16.2, U1.11 (SRN)
unnamed: C9.2, R14.2, U1.10 (SRP)
unnamed: C10.2, R24.1, U2.1 (Vin)
unnamed: C11.1, U2.3 (ONT)
unnamed: C12.1, U2.7 (PDT)
unnamed: C13.1, R26.1
unnamed: D1.1 (K), D2.1 (K), Q2.2 (G), R13.1, R17.2
unnamed: D1.2 (A), R10.1, R17.1
unnamed: D3.1 (K), R27.1
unnamed: J6.2 (Buttonpress), U2.5 (~INT)
unnamed: J6.3 (Shutdown), U2.8 (~KILL)
unnamed: Q1.1 (S), R7.1, R9.2, R16.1
unnamed: Q1.2 (G), R8.1, R9.1
unnamed: Q1.3 (D), Q2.3 (D)
unnamed: R8.2, U1.12 (DSG)
unnamed: R10.2, U1.13 (CHG)
unnamed: R11.1, U1.19 (VTB)
unnamed: R11.2, TH1.2, U1.18 (TS)
unnamed: R12.1, U1.17 (OCDP)
unnamed: R15.2, U1.14 (LD)
unnamed: R18.1, U1.22 (PRES)
unnamed: SW1.1, U2.2 (~PB)
PACK+: BT4.1 (1P), D3.2 (A), J2.1, J2.2, J3.1, J6.6 (PACK+), R1.2, R5.2, R19.1, R23.2, R24.2, R25.2, R26.2
PACK-: D2.2 (A), J3.2, J6.1 (PACK-), Q2.1 (S), R13.2, R15.1, R27.2
PRES: R18.2, R19.2

Notes on the sheet:
Connectors
If this Resistor is populated, Device is always on
override charge/discharge FETs GND or > VDD+0.7V: FETs controlled by protection logic > 2.04V && < VDD+0.7V: FET disabled (logic level 3.3V will turn off)
DCIN_Connected is High (PACK+), when DC Jack is inserted
BMS
Battery EN switch with controller IC, expensive
To disable Thermistor function: TH1: 10k resistor

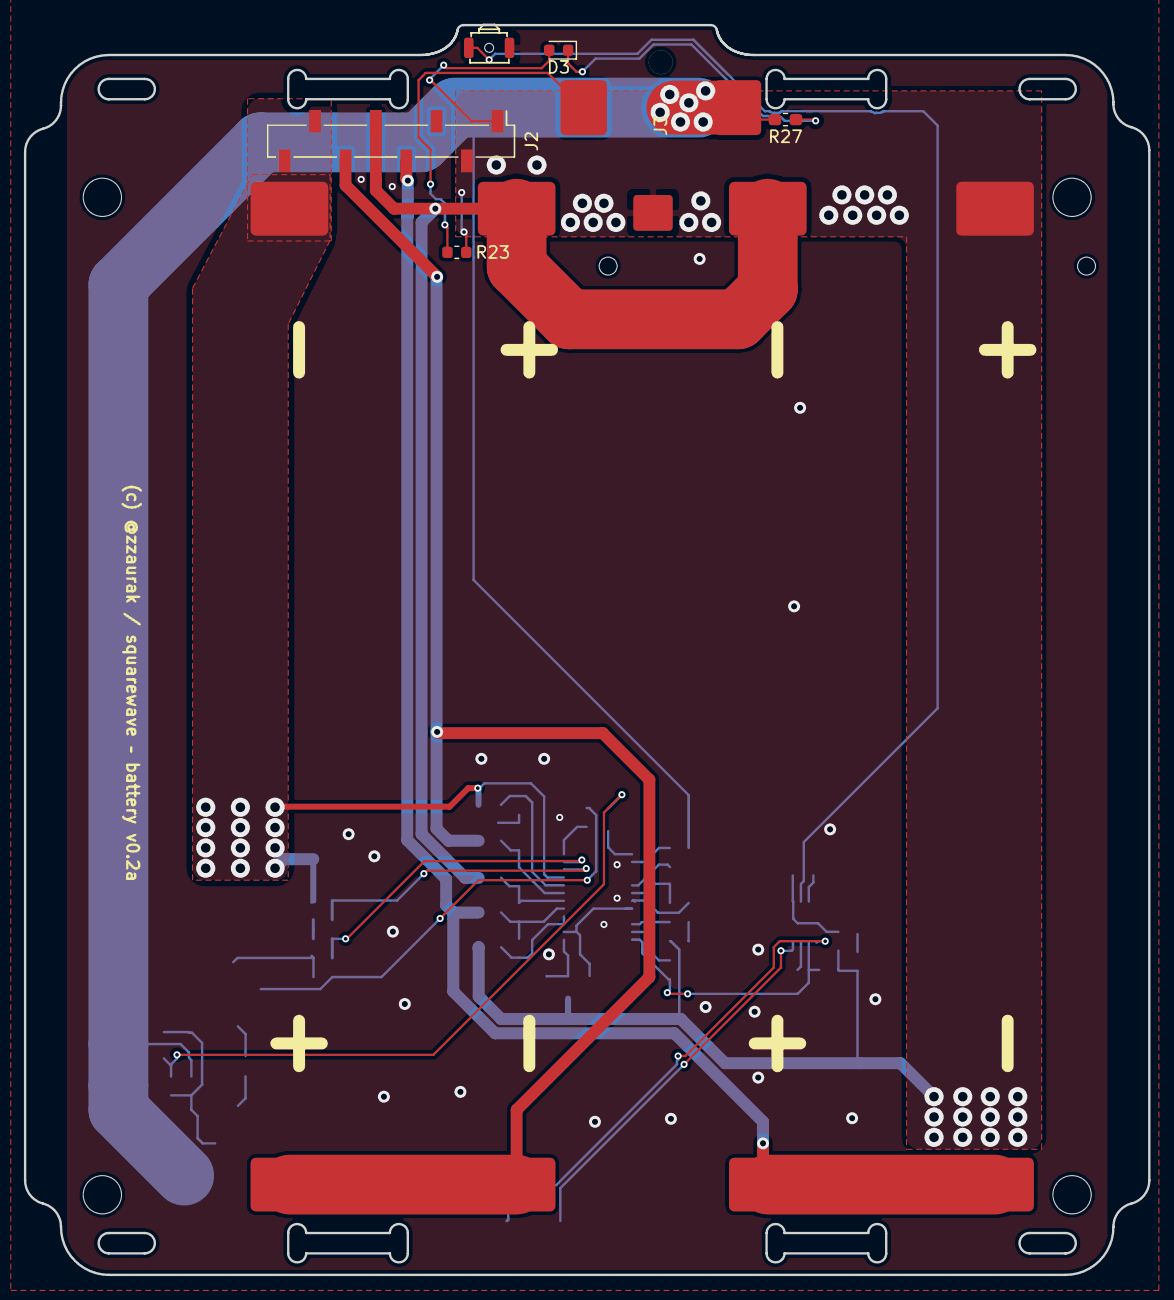
[picture p15: board kiss-battery_bottom.kicad_pcb from above]

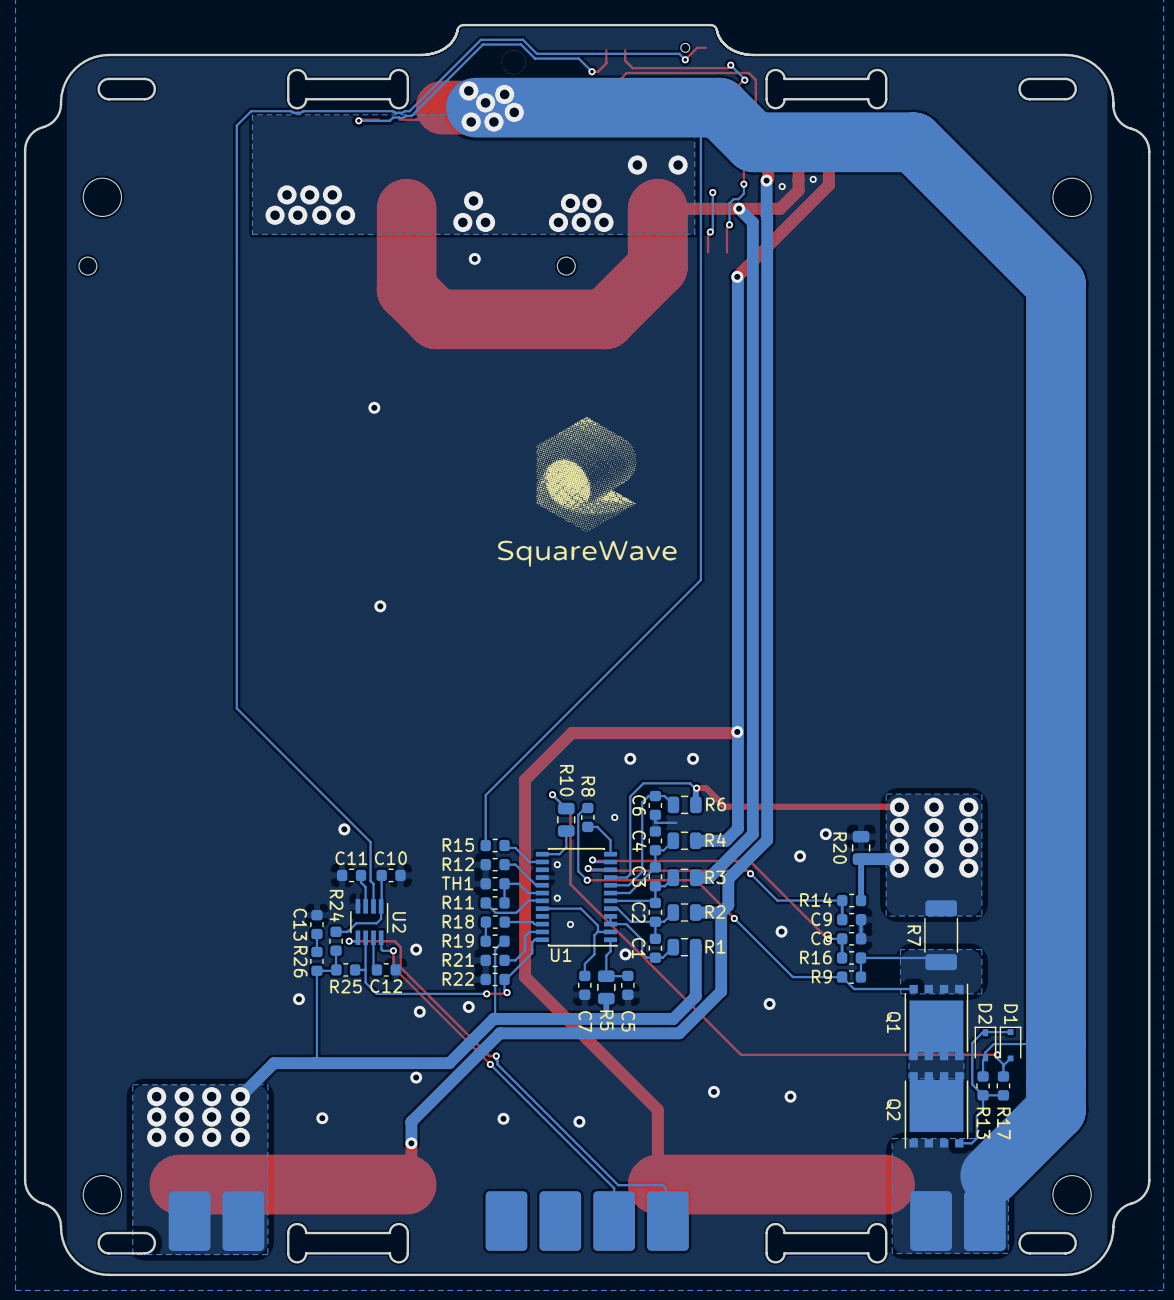
[picture p16: board kiss-battery_bottom.kicad_pcb from below]

Board: 2 copper layers, 94.0 x 104.5 mm, 59 parts (46 on the bottom side), 40 nets.
