squarewavedot/ledcubeelectronics/kiss-battery/v0.2/top/kiss-battery_top.kicad_pcb

## KiCad design kiss-battery/v0.2/top/kiss-battery_top.kicad_pcb (2020-10-03)

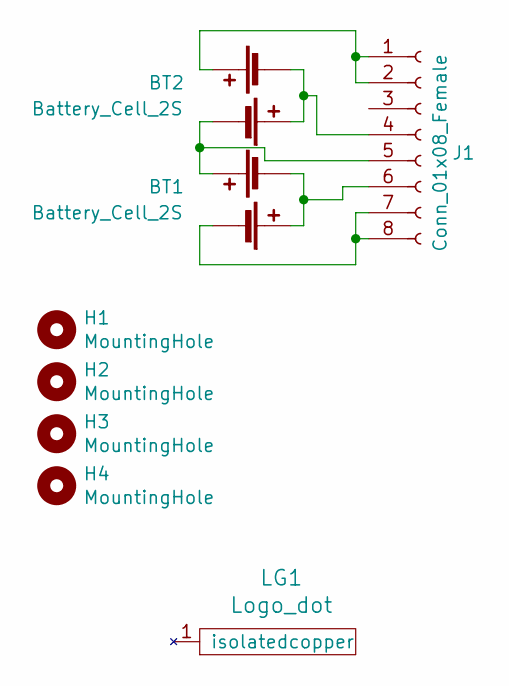
[picture p17: schematic kiss-battery_top.sch]

Parts:
BT1, BT2: Battery_Cell_2S; Battholder_18650x2_BLM
H1, H2, H3, H4: MountingHole; MountingHole_3.2mm_M3_ISO14580
J1: Conn_01x08_Female; PinSocket_1x08_P2.54mm_Vertical_SMD_Pin1Left
LG1: Logo_dot; Logo_Dot_15mm_Text_Mask

Connections:
unnamed: BT1.1 (1P), BT1.4 (2N), J1.6
unnamed: BT1.2 (1N), J1.7, J1.8
unnamed: BT1.3 (2P), BT2.2 (1N), J1.5
unnamed: BT2.1 (1P), BT2.4 (2N), J1.4
unnamed: BT2.3 (2P), J1.1, J1.2

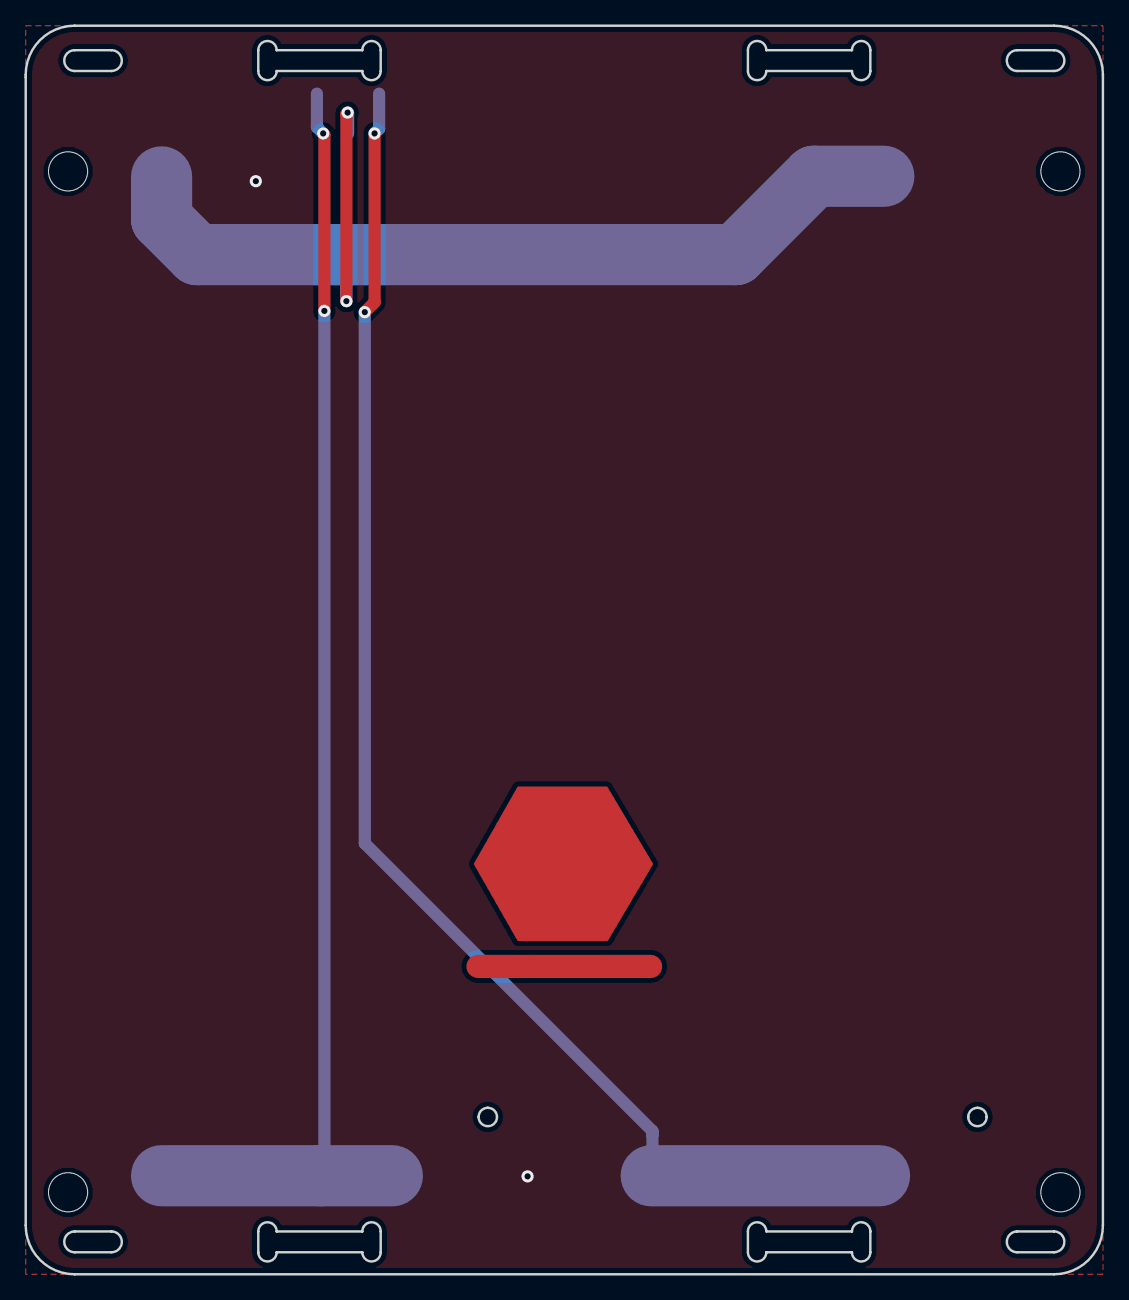
[picture p18: board kiss-battery_top.kicad_pcb from above]

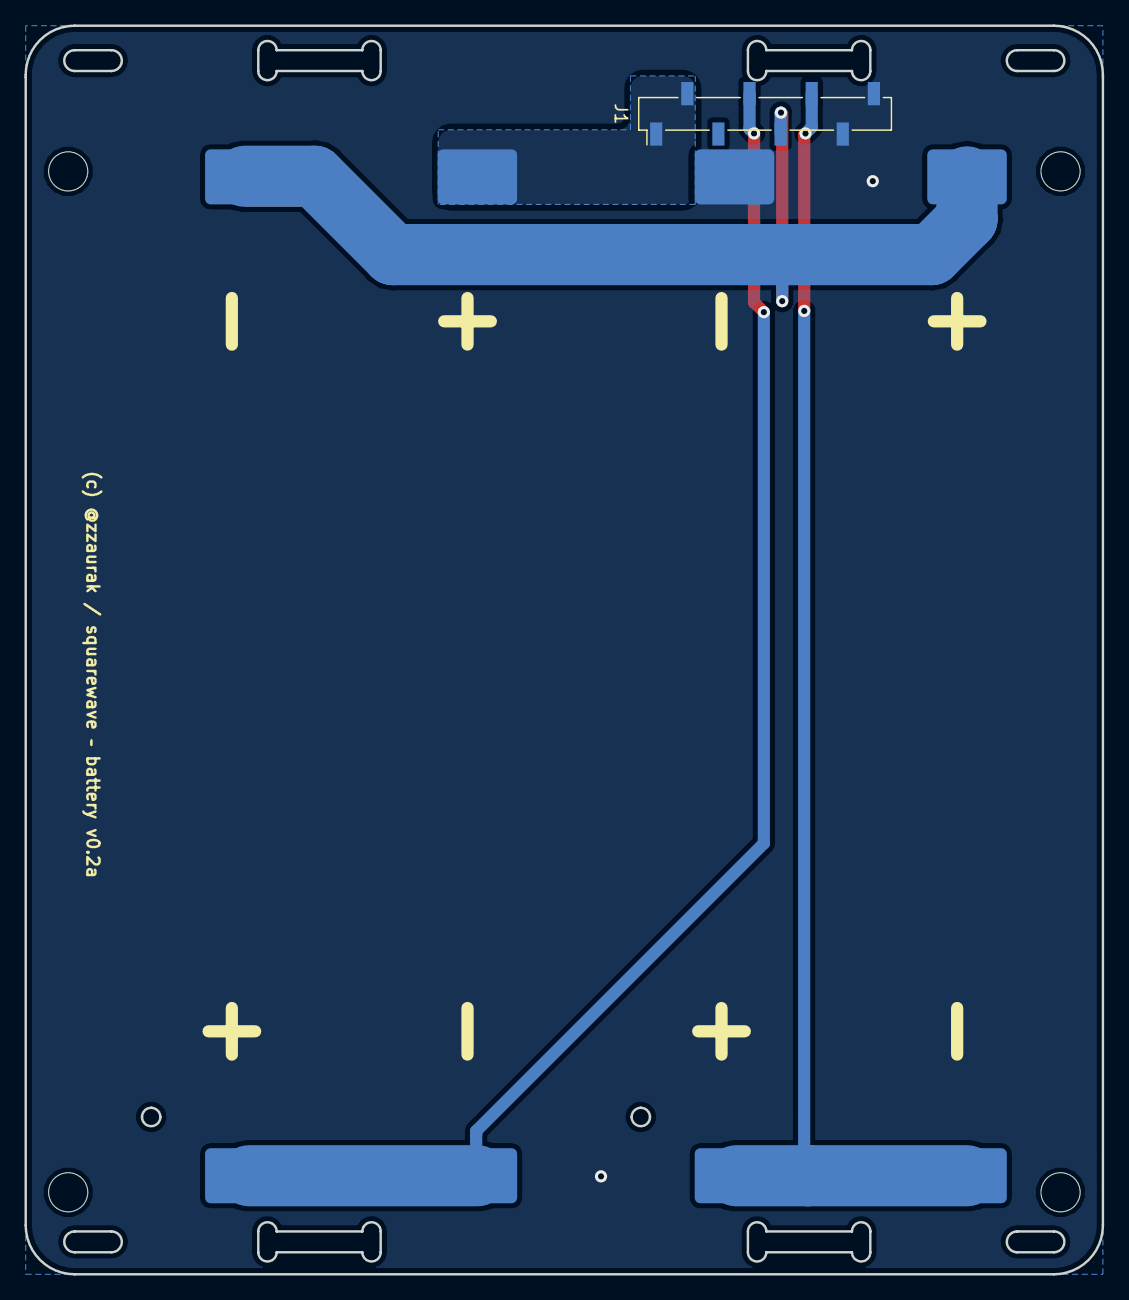
[picture p19: board kiss-battery_top.kicad_pcb from below]

Board: 2 copper layers, 88.0 x 102.0 mm, 8 parts (3 on the bottom side), 5 nets.
