squarewavedot/ledcubeelectronics/(commit log)

2026-04-28 wip: Added missing symbols, adjusted pcb layout
    [DigitalAudio.kicad_sch, FPGA.kicad_sch, PanelPower.kicad_sch, Raspi.kicad_sch, RaspiPower.kicad_sch, Sensors.kicad_sch, kiss-masterboard.kicad_pcb, kiss-masterboard.kicad_sch]
2026-05-04 add kiss-battery v0.2 bottom schematic, image exports, and BMS datasheets
    [kiss-battery_bottom.kicad_sch]
