squarewavedot/ledcubeelectronics/(notices)

Notices in the files:
kiss-masterboard/masterboard_v0.2/kiss-masterboard.sch:
License: CC-BY-SA V4.0
